psymon101/spinalhdlVDP/PROJECT_PLAN/sc17_hw_proof.png

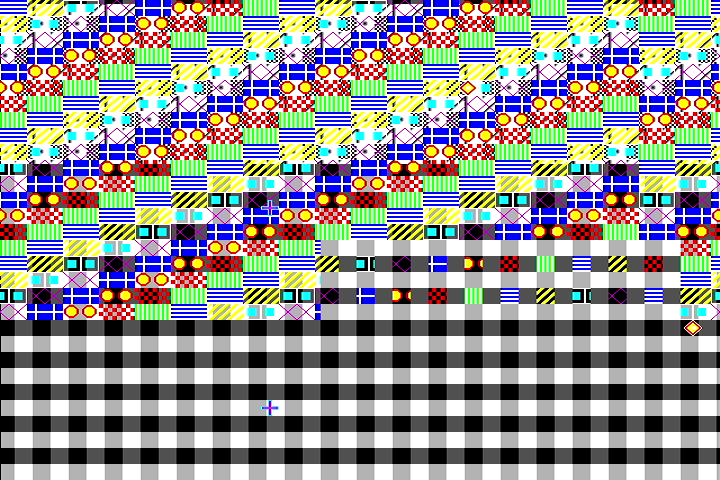
PROJECT_PLAN/sc17_hw_proof.png
