psymon101/spinalhdlVDP/PROJECT_PLAN/r53_hw_proof.png

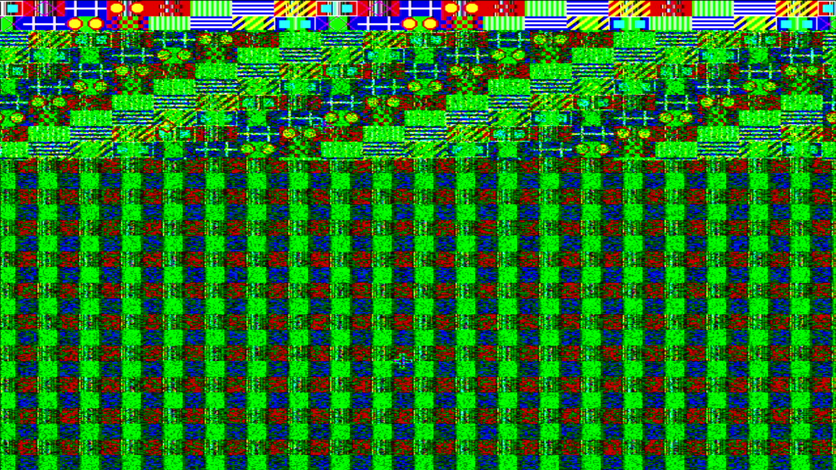
PROJECT_PLAN/r53_hw_proof.png
