psymon101/spinalhdlVDP/docs/external_documentation_system/docs/runbooks/08_RUN_HARDWARE_REGRESSION.md

# Run Hardware Regression

1. Verify source, bitstream, firmware, wiring, and asset hashes.
2. Program FPGA.
3. Flash host.
4. verify magic/ABI/capabilities;
5. run transport tests;
6. run Generic Mode0 tests;
7. run selected platform suite;
8. record status counters;
9. run reset/mode-switch tests;
10. run required soak;
11. capture direct-display and objective hash evidence;
12. complete proof packet.
