psymon101/spinalhdlVDP/docs/external_documentation_system/docs/testing/HARDWARE_PROOF_STANDARD.md

# Hardware Proof Standard

A proof identifies:

- source commit;
- generated RTL hash;
- bitstream hash;
- firmware hash;
- asset hashes;
- board and wiring revision;
- tool versions;
- exact commands;
- expected and actual results;
- status/error counters;
- test duration and reset count;
- reviewer.

A direct monitor is required for visual confirmation. Capture hardware is
secondary unless independently validated. Internal pixel hashes are preferred.
