psymon101/spinalhdlVDP/PROJECT_PLAN/BAD_APPLE_MODE0_DEMO.md

# BAD_APPLE_MODE0_DEMO.md

**Updated:** 2026-04-25  
**Purpose:** Define a bounded, explicitly non-roadmap demo experiment for playing a monochrome Bad Apple-style video directly on `Mode0` using the existing host-upload and bitmap-fetch infrastructure.

---

## Status

**Classification:** Fun / experimental demo  
**Roadmap status:** Not part of the formal adapter or substrate backlog  
**Intent:** Stress-test and showcase the existing host-upload + bitmap-fetch path without redefining core project scope

---

## Why This Exists

This demo asks a simple question:

> Can we preload a monochrome preprocessed video into SDRAM and display it on-screen using the current host + SDRAM + bitmap infrastructure?

This is **not** a C64 adapter goal and **not** a formal new `Mode0` primitive. It is a bounded experiment that may still teach useful lessons about:

- host preload throughput
- SDRAM write/update cadence
- bitmap fetch practicality
- what kinds of lightweight effects are possible on top of streamed content

---

## Scope

### In Scope

- monochrome video playback
- direct `Mode0` bitmap presentation
- preprocessed packed-monochrome frame playback from SDRAM
- one-shot preload or chunked rolling-buffer preload
- low-fps proof first
- optional visual effects layered on top later

### Explicitly Out of Scope

- audio playback
- C64-faithful presentation
- formal adapter work
- proving sustained high-bandwidth full-motion video as a guaranteed board capability
- changing project roadmap priority because the demo exists

---

## Recommended First-Cut Format

### Video Format

- resolution: `320x200`
- bit depth: `1bpp`
- packing: **packed monochrome**, `8 pixels per byte`, row-major
- palette: black / white
- source: offline-converted Bad Apple video frames

### Frame Size

`320 * 200 / 8 = 8000 bytes` per frame

### Initial Playback Goal

- first target: **10 fps**
- stretch target: **15 fps**
- do **not** assume `30 fps` as the first success criterion

---

## Playback Architecture

### High-Level Flow

```text
Bad Apple source video
  -> offline frame extraction + monochrome conversion
  -> packed 1bpp frame generation
  -> Pico 2 preload upload over QSPI
  -> SDRAM frame/chunk region
  -> Mode0 bitmap fetch
  -> fixed HDMI output
```

### Recommended First Strategy

Start with the simplest viable path:

1. preprocess source video into `320x200 1bpp` frames
2. preload full frames into SDRAM before playback begins
3. play locally from SDRAM at low fps
4. once proven, move to chunked rolling-buffer playback if the whole clip does not fit

### Better Practical Strategy

If the whole clip does not fit, switch to **chunked rolling-buffer preload**:

- preload several chunks before playback starts
- while chunk `N` is playing, upload future chunks
- reclaim already-consumed chunks and keep rotating through SDRAM

This keeps playback local to the Tang while only requiring the host link to stay ahead on average.

---

## Why `Mode0` Directly

This demo should target `Mode0` directly, not the C64 adapter, because:

- the goal is generic bitmap playback, not platform emulation
- `Mode0` already has bitmap-oriented substrate paths
- effects can be layered generically without pretending they are C64 semantics

This makes it a much cleaner stress/demo case.

---

## SDRAM / Fetch Model

### First-Cut Memory Model

- one or more SDRAM regions for packed-monochrome frames
- `Mode0` bitmap fetch reads from the active frame region
- playback logic advances frame/chunk pointers locally

### Optional Future Improvement

- dual frame regions with explicit swap control
- chunk ring-buffer with descriptor table for longer clips

This is not required for the first proof.

---

## Bandwidth Sanity Check

### Raw Full-Frame Cost

- frame size: `8000 bytes`
- `10 fps` -> `~80 KB/s`
- `15 fps` -> `~120 KB/s`
- `30 fps` -> `~240 KB/s`

These numbers exclude protocol overhead and control traffic.

### Interpretation

- low-fps monochrome playback is plausibly within reach
- raw full-frame `30 fps` should **not** be assumed without measurement
- preload-first playback is the preferred real path after initial proof
- chunked rolling-buffer preload is preferred over naive live streaming for larger clips

---

## Visual Presentation

### First Proof

- black / white monochrome
- no attempt to mimic C64, ZX, or any historical machine
- centered or letterboxed inside the fixed output raster

### Later Fun Additions

Once the basic stream works, allowed demo-only effects include:

- palette tinting
- raster splits
- overlay text/HUD
- sprite overlays
- window reveals / masks
- simple affine or distortion-style presentation if it can be layered cheaply

These remain demo effects, not new scope commitments.

---

## Implementation Phases

### Phase A — Static Bitmap Proof

Goal:

- host uploads one `320x200 1bpp` frame to SDRAM
- `Mode0` displays it correctly

Exit:

- clear visible static image on the HDMI output

### Phase B — Low-FPS Local Playback

Goal:

- host preloads successive packed-monochrome frames
- Tang plays locally from SDRAM
- playback is visibly recognizable as motion

Exit:

- a short recognizable monochrome animation at low fps

### Phase C — Chunked Rolling-Buffer Playback

Goal:

- host preloads several chunks ahead
- Tang consumes them locally while the host refills freed chunks
- full clip length exceeds one-shot SDRAM capacity

Exit:

- stable longer-form playback beyond one-shot SDRAM fit

### Phase D — Fun Effects

Goal:

- layer one or more generic `Mode0` effects over the streamed video

Exit:

- a visibly stylized demo without redefining mainline project scope

---

## Success Criteria

For the first success claim, the demo only needs to prove:

1. a preprocessed monochrome video frame can be uploaded by the host
2. `Mode0` can display the uploaded bitmap on screen
3. repeated updates produce recognizable motion

It does **not** need to prove:

- maximum fps
- zero tearing
- production-quality streaming protocol
- general-purpose video playback as a formal project feature

---

## Non-Goals / Guardrails

- Do not let this demo silently become a formal backlog commitment.
- Do not treat success here as proof that full-framebuffer video streaming is generally cheap on Tang Nano 20K.
- Do not widen `Mode0` for demo-only convenience without a separate architectural decision.
- Do not let the fun demo override `MODE0_PLANNING.md` §2 (Resource Stop-Lines).

---

## Recommended Next Concrete Step

If the team chooses to try this, the first implementation target should be:

- **Phase A — Static Bitmap Proof**

That will answer the first real question quickly:

- can the current host-upload + bitmap-fetch path display a streamed `320x200 1bpp` image cleanly enough to make the rest of the demo worth pursuing?
