psymon101/spinalhdlVDP/docs/firmware/HOST_TRANSPORT_ABI.md

> Live project state is maintained in repository-root `STATUS.md`. This document does not own active-lane status, blockers, or engineering history.

# Host Transport ABI

**Status:** draft  
**Owner:** `BronzeGate`  
**Reviewer:** `TopazCliff`, `BrightForge`

## Scope

Host-facing transport protocol for configuring the Tang Nano 20K VDP.

## Canonical host path

- **QSPI / ESP32-P4** is the canonical Tang Nano 20K host path.
- Components: `QspiSlave` / `QspiDecoder` / `QspiSdramBridge`.
- Historical i80/ESP32-S3 and legacy SPI paths are retired as primary targets.

## Transport rate

- **4 MHz** is the canonical bulk SDRAM upload clock for the current wiring.
- Legacy SPI contract: 2 MHz SCK, 10 µs CS hold, 20 µs OSR drain.

## Transport health

- Health selector: active word-drain `sel=0x0A`.
- `raw=0x00000000`, `overflow=0`, `malformed=0` expected in clean operation.
- Silent value corruption (no health flag) is a known SI-margin risk at higher
  rates; mitigated by 4 MHz canonical rate.

## Public API

Reusable host logic belongs in `firmware/libvdp/`. Applications remain thin
wrappers.

## Bitmap/indexed `SCALE_CTRL` semantics (P3b interface checkpoint)

BronzeGate concurs with BrightForge's **Option B — Compose**, pending PM and
CyanPeak review. The existing bitmap/indexed path's fixed 2× source-to-display
mapping remains part of the contract; `SCALE_CTRL` applies to the logical
coordinates before bitmap fetch. Therefore a bitmap's effective display scale
per axis is `2 × SCALE_CTRL` (subject to the active-display clamp), and the
default `scaleX=1`, `scaleY=1` remains byte-identical to the HW-proven
`a5a047a2` path.

Consequences for host code:

- A full 320×240 bitmap at `scaleX=scaleY=2` requests a 4× effective image and
  is larger than the 640×480 active area; use `LOGIC_WIDTH`/`LOGIC_HEIGHT` to
  crop the logical source before scaling when a zoomed image should fit.
- Write logical dimensions before `SCALE_CTRL`, using the existing
  `vdp_mode0_set_scale_mode()` helper or the equivalent two helpers.
- No new register, command, or libvdp helper is required. Existing scale
  fields retain their encoding; this section defines their bitmap/indexed
  fetch-side meaning for P3b.
- This semantic decision does not authorize RTL changes by itself. BrightForge
  must complete the checkpoint review, co-sim, and PnR gates before the fetch
  path changes.

## References

- `firmware/libvdp/`
- `firmware/GOTCHAS.md`
- `STATUS.md` lanes `QSPI-SI-CEILING-183`, `HAM6 removal + 2bpp indexed replacement`
