psymon101/spinalhdlVDP/docs/external_documentation_system/docs/platforms/amiga_ocs_ecs/README.md

# Amiga OCS/ECS

- **Current state:** BLOCKED — after Atari ST/STE
- **Dependencies:** independent 1–6 plane fetch, Copper, shared sprites, Blitter

## Documents

1. `SCOPE_AND_VIDEO_MODEL.md`
2. `FPGA_SPINALHDL_PLAN.md`
3. `FIRMWARE_LIBVDP_PLAN.md`
4. `TEST_AND_REVIEW_PLAN.md`
5. `LIMITATIONS_AND_DEFERRED.md`
6. `REFERENCES.md`

## Lane rule

No implementation starts before the research packet and design checkpoint are
approved. The adapter must reuse common engines unless an approved requirement
cannot be represented by them.
