psymon101/spinalhdlVDP/EDUCATION/05_FPGA_ARCHITECTURE.md

# FPGA Architecture and Resource Optimization

This document describes how the VDP SpinalHDL code is compiled, mapped to physical FPGA resources, and optimized to fit the constraints of the Gowin GW2AR-18 device.

---

## 1. Gowin GW2AR-18 Architecture Overview

The **Tang Nano 20K** board features a Gowin GW2AR-LV18QN88C8/I7 FPGA. This chip has the following logic capacity:

| Resource Type | Available Count | Description |
|---|---|---|
| **LUT4** (Look-Up Table) | 20,736 | 4-input logic function generators |
| **DFF** (Flip-Flops) | 15,552 | 1-bit memory elements (registers) |
| **BSRAM** (Block SRAM) | 46 blocks | On-chip memory blocks (18 Kbits each) |
| **DSP Blocks** | 40 blocks | Dedicated multiplier / ALU blocks |

---
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
