psymon101/spinalhdlVDP/firmware/zx_final_proof_v4.png

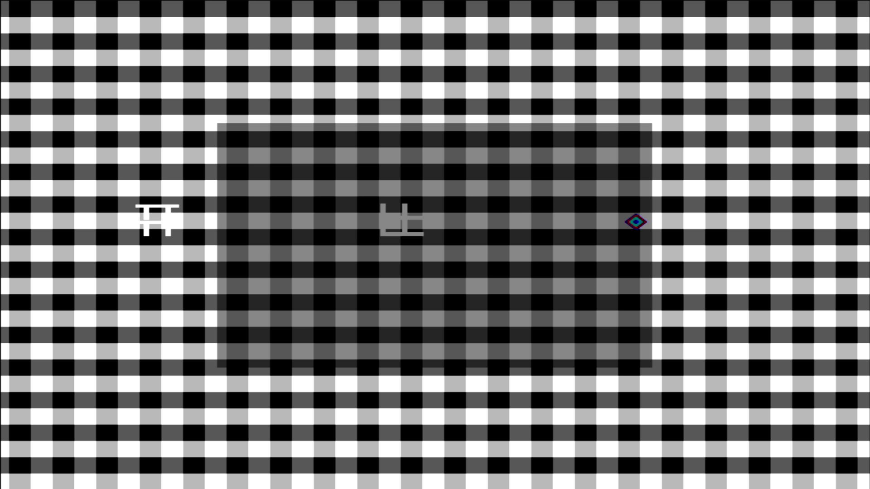
firmware/zx_final_proof_v4.png
