psymon101/spinalhdlVDP/PROJECT_PLAN/proof_packets/2bpp-hardware-reproof-4mhz/yuyv_exact_approved_frame_01.png

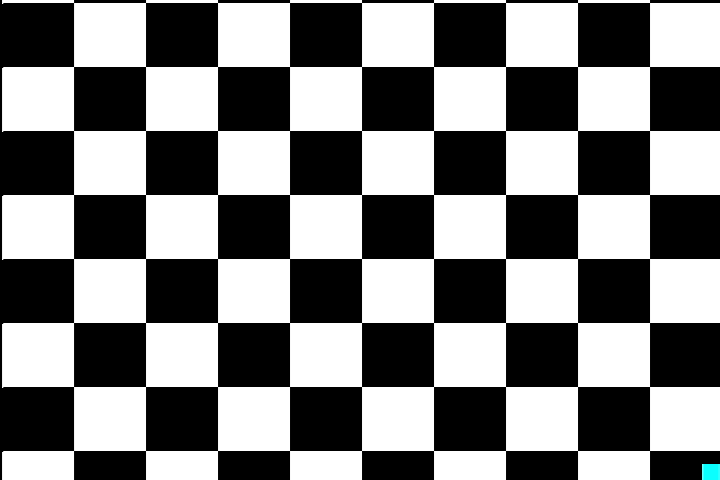
PROJECT_PLAN/proof_packets/2bpp-hardware-reproof-4mhz/yuyv_exact_approved_frame_01.png
