psymon101/spinalhdlVDP/PROJECT_PLAN/proof_packets/qspi-upload-si-hardening/captures/indirect_display_frame_01.png

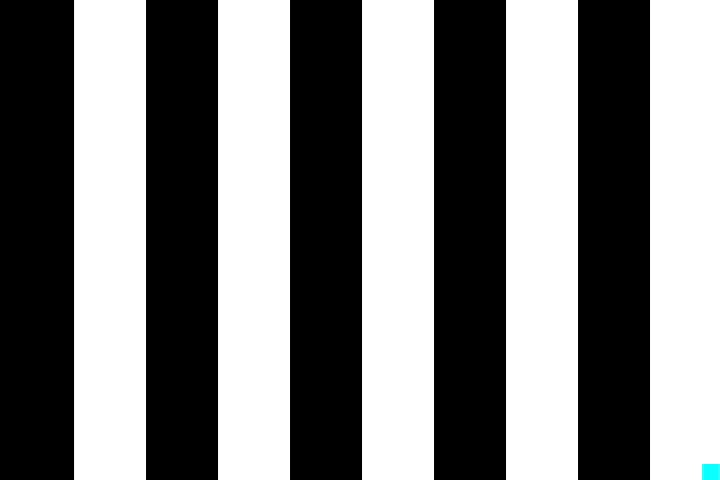
PROJECT_PLAN/proof_packets/qspi-upload-si-hardening/captures/indirect_display_frame_01.png
