psymon101/spinalhdlVDP/PROJECT_PLAN/proof_packets/scaler-rewrite-hw-proof/captures/phaseC_2x/mode2_2x_scaled.png

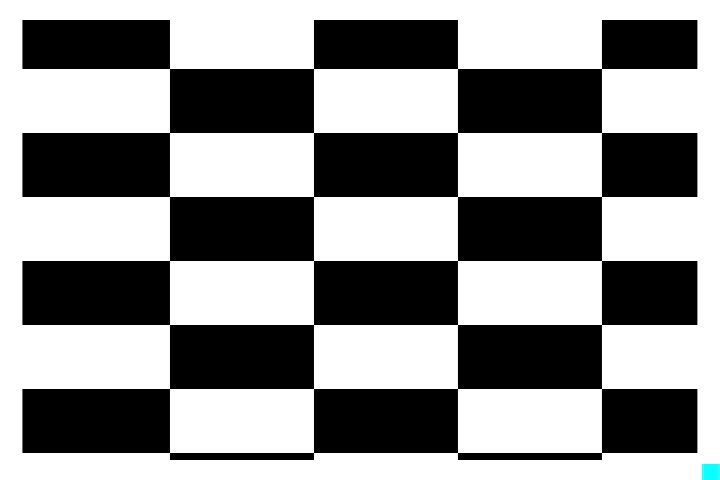
PROJECT_PLAN/proof_packets/scaler-rewrite-hw-proof/captures/phaseC_2x/mode2_2x_scaled.png
