psymon101/spinalhdlVDP/PROJECT_PLAN/proof_packets/scaler-rewrite-hw-proof/captures/phaseC_3x/mode3_3x_scaled.png

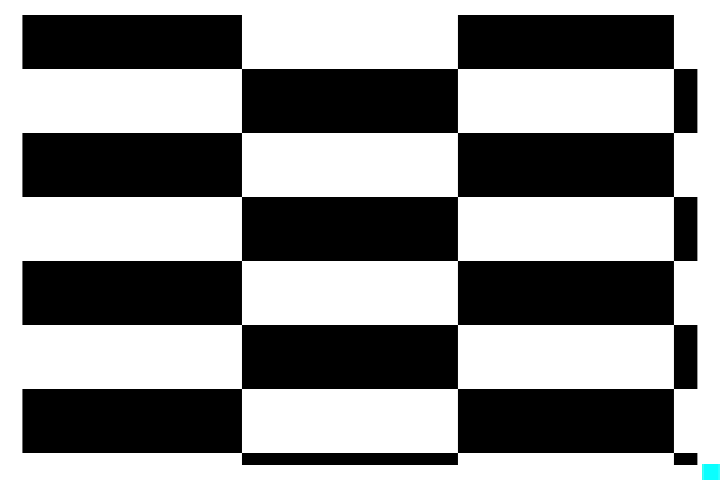
PROJECT_PLAN/proof_packets/scaler-rewrite-hw-proof/captures/phaseC_3x/mode3_3x_scaled.png
