psymon101/spinalhdlVDP/PROJECT_PLAN/r41c_hw_proof.png

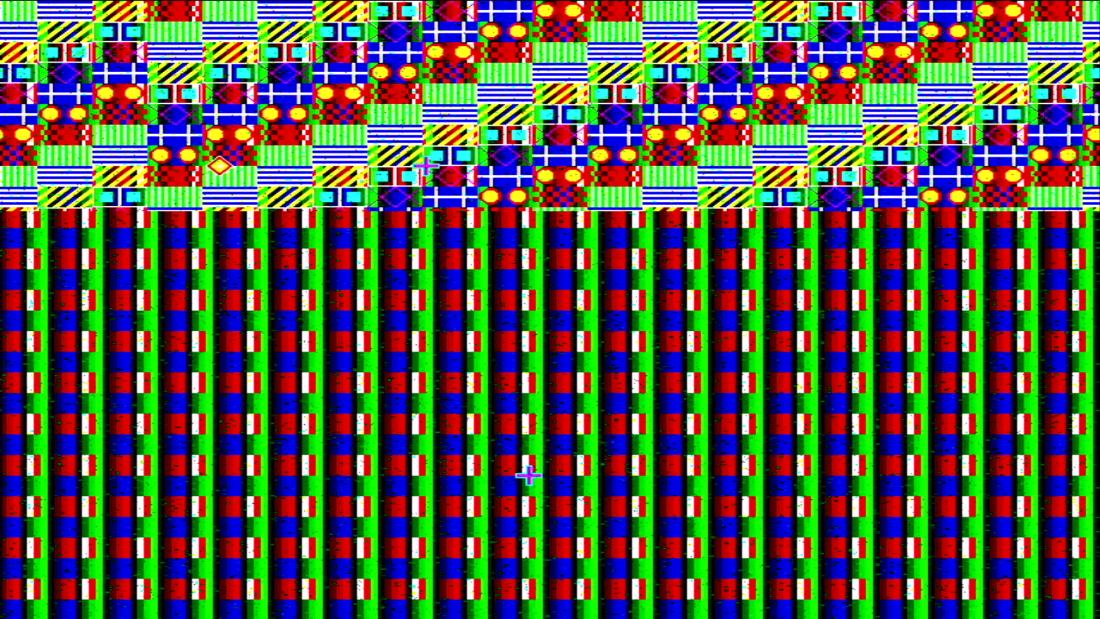
PROJECT_PLAN/r41c_hw_proof.png
