psymon101/spinalhdlVDP/PROJECT_PLAN/sc12_hw_proof.png

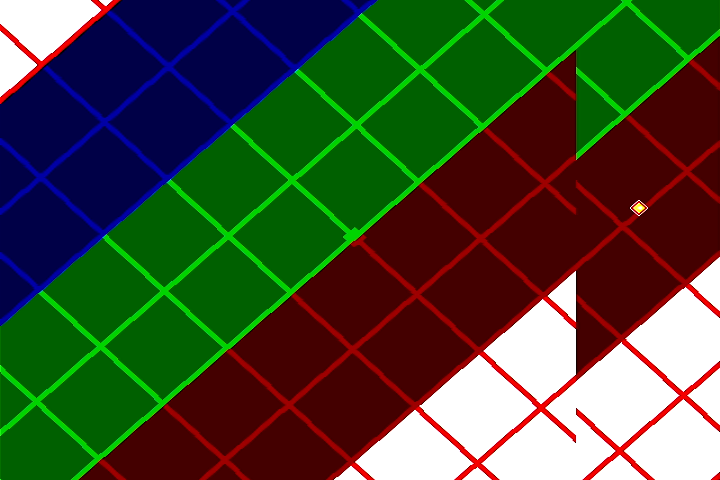
PROJECT_PLAN/sc12_hw_proof.png
