psymon101/spinalhdlVDP/PROJECT_PLAN/sc13_hw_proof.png

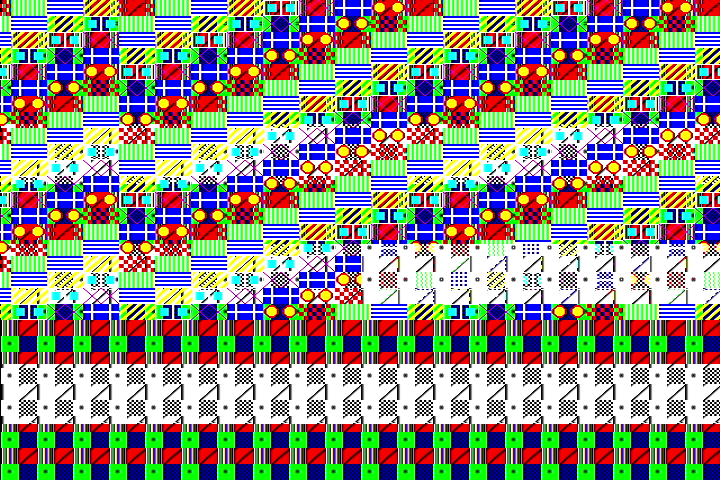
PROJECT_PLAN/sc13_hw_proof.png
