psymon101/spinalhdlVDP/docs/external_documentation_system/docs/runbooks/07_BUILD_ESP32_P4.md

# Build ESP32-P4 Backend

Status: blocked until the P4 backend is integrated into `libvdp`.

The final runbook must cover:

- exact ESP-IDF version;
- board/pin definition;
- required I/O power-domain setup;
- chosen i80/PARLIO or approved transport;
- write framing;
- manual or hardware readback;
- build, flash, and monitor commands;
- transport conformance and Generic Mode0 proof.
