psymon101/spinalhdlVDP/docs/runbooks/BUILD_LIBVDP.md

> Live project state is maintained in `PROJECT_PLAN/STATUS.md`. This document does not own active-lane status, blockers, or engineering history.

# Runbook: Build libvdp

**Owner:** `BronzeGate`  
**Status:** template — requires validation for CMake target

## Working directory

`/home/itadmin/github/spinalhdlVDP/firmware/libvdp`

## Prerequisites

- Platform toolchain installed (ESP-IDF v6.0.2 for ESP32-P4).

## Command

```bash
# TBD — validate with BronzeGate
```

## Expected outputs

- Compiled `libvdp` object files / static library.

## Pass/fail criteria

- Build exits 0 with no warnings treated as errors.

## Evidence to save

- Build log.
- Commit hash.
