psymon101/spinalhdlVDP/docs/external_documentation_system/docs/runbooks/01_SETUP_DEVELOPMENT_ENVIRONMENT.md

# Setup Development Environment

This runbook is not complete until Foundation 0 locks exact versions.

1. Acquire the supported OS/container.
2. Verify source archive hash.
3. Install the locked JDK, Scala, sbt, SpinalHDL, simulator, Gowin EDA,
   host SDK, compiler, Python, CMake, and flashing tools.
4. Run `tools/verify_toolchain` once implemented.
5. Clone/checkout the locked commit.
6. Confirm clean tree.
7. Run the smoke build.
8. Save `tool_versions.txt`.

All exact commands and expected versions remain `TBD-FOUNDATION-0`.
