psymon101/spinalhdlVDP/docs/external_documentation_system/docs/runbooks/06_BUILD_LIBVDP_AND_REFERENCE_FIRMWARE.md

# Build libvdp and Reference Firmware

1. Verify ABI/register generated headers.
2. Build the authoritative host target.
3. Build secondary supported targets.
4. Build Generic Mode0 example.
5. Build every closed platform example.
6. run software unit/mock tests;
7. record binary hashes and map/size reports.
