psymon101/spinalhdlVDP/docs/external_documentation_system/docs/runbooks/09_BUILD_RELEASE.md

# Build Release

1. require all milestone lanes closed;
2. run clean-room build;
3. generate and hash RTL;
4. synthesize and hash bitstream;
5. build and hash firmware;
6. package source, manifests, reports, tests, docs, and proofs;
7. verify archive from a new extraction;
8. collect all sign-offs.
