psymon101/spinalhdlVDP/PROJECT_PLAN/proof_packets/standalone-diagnostic-build/captures/coldpor_cycle01.png

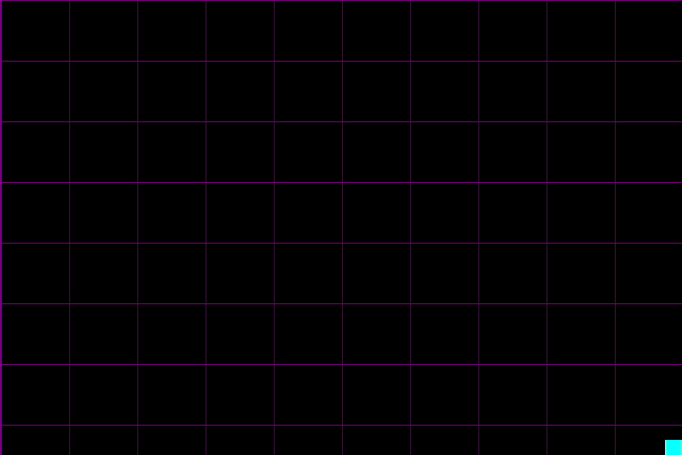
PROJECT_PLAN/proof_packets/standalone-diagnostic-build/captures/coldpor_cycle01.png
