psymon101/spinalhdlVDP/docs/external_documentation_system/docs/testing/GOLDEN_VECTORS.md

# Golden Vectors

Every closed engine/platform publishes:

- smallest legal vector;
- representative vector;
- boundary/stress vector;
- invalid vector;
- raster vector where applicable;
- input hashes;
- expected pixel/line/frame hashes;
- expected status bits;
- expected transaction trace.

Random failures become permanent seeded regressions.
