psymon101/spinalhdlVDP/docs/external_documentation_system/docs/platforms/amiga_ocs_ecs/TEST_AND_REVIEW_PLAN.md

# Amiga OCS/ECS — Test and Review Plan

## Required tests

- AMIGA-SIM-001..006 plane counts
- AMIGA-SIM-010 independent bases
- AMIGA-SIM-011 odd/even modulo
- AMIGA-SIM-020 dual playfield
- AMIGA-SIM-030 sprites/attached
- AMIGA-SIM-040 Copper mid-line
- AMIGA-SIM-050 EHB
- AMIGA-SIM-060 HAM6 and line reset
- AMIGA-HW-001 Blitter-generated proof

## Test case template

Every test states:

- requirement IDs;
- exact input vector and hash;
- initial register/memory state;
- simulation or hardware command;
- expected pixel/line/frame hash;
- expected status flags;
- maximum latency/time;
- pass/fail condition;
- evidence path.

## Review sequence

1. platform research review;
2. design/Mode0 mapping review;
3. SpinalHDL unit review;
4. SpinalSim review;
5. `VdpTop`/SDRAM integration review;
6. `libvdp` API review;
7. schema/document synchronization;
8. synthesis/timing/resource review;
9. hardware proof review;
10. independent clean-room/doc audit.

## Closure

All supported claims must map to passing tests. Visual inspection alone cannot
close the lane.
