psymon101/spinalhdlVDP/PROJECT_PLAN/external_review/full_codebase_audit_2026-07-27/final_verification_2026-08-03/README.md

# Final Verification Package — `codebase-cleanup-status-contract`

**Date:** 2026-08-03  
**Lane:** `codebase-cleanup-status-contract`  
**Branch:** `brightforge/status-contract-cleanup` (base `main` `fd39d2b0`)  
**PM:** TopazCliff  

This package contains everything the external AI reviewer needs for the **final verification gate** before the Project Lead authorizes merging the cleanup lane into `main`.

## Files

| File | Purpose |
|---|---|
| `final_verification_request_for_external_ai.md` | The verification request with context, questions, and verdict format. |
| `rtl_implementation_bundle.md` | High-level contract map, source-diff summary, simulation results, PnR summary, and artifact hashes. |
| `rtl_source.diff` | 261-line full diff of `main..brightforge/status-contract-cleanup`. |
| `review.md` | CyanPeak's Step C firmware contract-sync verdict (PASS). |
| `hashes.sha256` | SHA-256 hashes of firmware build artifacts. |
| `manifest.yaml` | Proof-packet manifest with commit references and mail threads. |

## Reference contract

The approved host-visible contract is in:

`PROJECT_PLAN/external_review/full_codebase_audit_2026-07-27/rule19_signoff_request.md`

## Gate status

- Rule 19 sign-off: BrightForge #14629, BronzeGate #14631, External AI approval ✅
- CyanPeak code-to-spec review: PASS (#14647) ✅
- BronzeGate Step C firmware/header sync + builds: PASS (#14650) ✅
- BrightForge Step B RTL + sim + PnR: PASS (#14643) ✅
- **Remaining gate:** External AI final verification → PM merge authorization.
