psymon101/spinalhdlVDP/kb/TEMPLATE_ADAPTER/TEST_AND_PROOF_PLAN.md

> Live project state is maintained in repository-root `STATUS.md`. This document does not own active-lane status, blockers, or engineering history.

# `<Adapter>` Test and Proof Plan

**Owner:** BrightForge + BronzeGate  
**Reviewers:** advisory reviewers as activated

## Simulation tests

| Test ID | Requirement | Owner | Command | Pass criteria |
|---|---|---|---|---|

## Hardware proof

| Test ID | Procedure | Owner | Pass criteria | Evidence |
|---|---|---|---|---|

## Golden vectors

## Proof packet location

`PROJECT_PLAN/proof_packets/<LANE>/`
