psymon101/spinalhdlVDP/PROJECT_PLAN/external_review/full_codebase_audit_2026-07-27/final_verification_2026-08-03/review.md

# Step C review

Verdict: PASS for the BronzeGate firmware scope.

Evidence:

- Source commit `a5f2aaa93e89d3afbb4b0adf041eb19582508251` contains only the
  five assigned firmware contract/schema files.
- ESP32-P4 proof builds for modes 0, 2, and 3 passed with ESP-IDF v6.0.2.
- Artifact hashes are recorded in `hashes.sha256`.
- `git diff --check` passed before the source commit.
- JSON validation passed with `python3 -m json.tool firmware/libvdp/mode0_regs.json`.
- No merge was attempted. External-AI final verification and explicit PM merge
  authorization remain open gates.
