psymon101/spinalhdlVDP/PROJECT_PLAN/proof_packets/scaler-rewrite-merge-prep/simulation/results.txt

Indexed2bppFineCoSim=0
Indexed2bppCheckerCoSim=0
Indexed2bppFrameCoSim=0
DirectColorFrameCoSim=0
pnr=0
