psymon101/spinalhdlVDP/docs/external_documentation_system/docs/platforms/atari_2600_tia/TEST_AND_REVIEW_PLAN.md

# Atari 2600 TIA — Test and Review Plan

## Required tests

- TIA-SIM-001 playfield reflection
- TIA-SIM-010 player copy/size
- TIA-SIM-020 missile/ball
- TIA-SIM-030 motion
- TIA-SIM-040 priority
- TIA-SIM-050 collision matrix
- TIA-HW-001 timed mid-line proof

## Test case template

Every test states:

- requirement IDs;
- exact input vector and hash;
- initial register/memory state;
- simulation or hardware command;
- expected pixel/line/frame hash;
- expected status flags;
- maximum latency/time;
- pass/fail condition;
- evidence path.

## Review sequence

1. platform research review;
2. design/Mode0 mapping review;
3. SpinalHDL unit review;
4. SpinalSim review;
5. `VdpTop`/SDRAM integration review;
6. `libvdp` API review;
7. schema/document synchronization;
8. synthesis/timing/resource review;
9. hardware proof review;
10. independent clean-room/doc audit.

## Closure

All supported claims must map to passing tests. Visual inspection alone cannot
close the lane.
