psymon101/spinalhdlVDP/docs/external_documentation_system/docs/platforms/genesis/TEST_AND_REVIEW_PLAN.md

# Sega Mega Drive/Genesis — Test and Review Plan

## Required tests

- GEN-SIM-001 A/B/window priority
- GEN-SIM-010 tile priority/flips
- GEN-SIM-020 scroll modes
- GEN-SIM-030 sprite boundary
- GEN-SIM-040 shadow/highlight
- GEN-HW-001 width/mode proof

## Test case template

Every test states:

- requirement IDs;
- exact input vector and hash;
- initial register/memory state;
- simulation or hardware command;
- expected pixel/line/frame hash;
- expected status flags;
- maximum latency/time;
- pass/fail condition;
- evidence path.

## Review sequence

1. platform research review;
2. design/Mode0 mapping review;
3. SpinalHDL unit review;
4. SpinalSim review;
5. `VdpTop`/SDRAM integration review;
6. `libvdp` API review;
7. schema/document synchronization;
8. synthesis/timing/resource review;
9. hardware proof review;
10. independent clean-room/doc audit.

## Closure

All supported claims must map to passing tests. Visual inspection alone cannot
close the lane.
