psymon101/spinalhdlVDP/docs/external_documentation_system/docs/platforms/zx_spectrum/TEST_AND_REVIEW_PLAN.md

# ZX Spectrum — Test and Review Plan

## Required tests

- ZX-SIM-001 shuffled address vectors
- ZX-SIM-002 attribute truth table
- ZX-SIM-003 flash cadence/reset
- ZX-SIM-004 border boundary
- ZX-HW-001 attribute-clash scene
- ZX-HW-002 cold/reset/mode soak

## Test case template

Every test states:

- requirement IDs;
- exact input vector and hash;
- initial register/memory state;
- simulation or hardware command;
- expected pixel/line/frame hash;
- expected status flags;
- maximum latency/time;
- pass/fail condition;
- evidence path.

## Review sequence

1. platform research review;
2. design/Mode0 mapping review;
3. SpinalHDL unit review;
4. SpinalSim review;
5. `VdpTop`/SDRAM integration review;
6. `libvdp` API review;
7. schema/document synchronization;
8. synthesis/timing/resource review;
9. hardware proof review;
10. independent clean-room/doc audit.

## Closure

All supported claims must map to passing tests. Visual inspection alone cannot
close the lane.
