psymon101/spinalhdlVDP/docs/troubleshooting/README.md

> Live project state is maintained in repository-root `STATUS.md`. This document does not own active-lane status, blockers, or engineering history.

# Troubleshooting

Known issues, diagnostic steps, and recovery procedures.

Each entry references the governing specification and the relevant runbook.
Do not duplicate live status or proof results.
