psymon101/spinalhdlVDP/PROJECT_PLAN/TASKS_HISTORY.md

# TASKS_HISTORY.md

**Version:** 1.1-draft  
**Author:** CyanPeak (audit update)  
**Date:** 2026-05-24 (Lane #10567 closure added)  
**Purpose:** Deep historical record for closed lanes, extended task writeups, and archived execution detail. `TASKS.md` remains the sole active task authority; this file is reference only.

---

### RTL Platform-Agnosticism Purge (CLOSED)

| Field | Value |
|---|---|
| **Task** | RTL Platform-Agnosticism Purge (#10567) |
| **Status** | **DONE** — CyanPeak audit PASS #10587 |
| **Phase** | closed |
| **Owner** | BrightForge (deletion), CyanPeak (audit), TopazCliff (coordination) |
| **Baseline Commit** | `8b61a2e` (RTL Cleanup) |
| **Commits in lane** | `66dc25f` (RTL purge) |
| **Latest Auth Mail** | #10567 (Lane Open), #10576 (Scope Change), #10581 (Audit GO), #10587 (Audit PASS) |
| **Proof** | Generic sims PASS: \`TileAttributeFetchSim\`, \`SdramTileFetchSim\`, \`SpriteSpriteCollisionSim\`. Recursive grep returns zero behavioral matches in \`hw/spinal/\`. |
| **Next Deliverable** | N/A — Lane #10567 closed |

**Scope:** Strip all platform-specific RTL (adapters, shims, hardcoded assets, and scenarioId parameterization) to enforce the **RTL Agnosticism** principle. Personality moves to \`libvdp\`.

**Implementation:**
- Deleted 10 files covering Tier 1/2 platform IP (C64, ZX, Mode-Select).
- Scrubbed \`TopTang20kHdmi.scala\`: dropped \`scenarioId\` and \`useHostInit\` parameters. Folded all per-scenario logic into a single generic 'Pure Host' path.
- Removed hardcoded palettes from \`TileAttributeAssets.scala\`.
- Cleaned up stale platform-specific comments in core VDP logic.

**Orphan Retentions:** \`C64CharRom.scala\` and \`peptoPalette\` retained for future firmware-side backfill.

---

### Task 54 — Sprite-Sprite Collision Detector (CLOSED)

| Field | Value |
|---|---|
| **Task** | Task 54 — Sprite-Sprite Collision Detector |
| **Status** | **DONE** — CyanPeak audit PASS #9672; sim-only proof |
| **Phase** | closed |
| **Owner** | BrightForge (implementation + proof), CyanPeak (audit PASS), CoralReef (ledger sync) |
| **Baseline Commit** | `fae0585` (Task 57 closure, descCount=8 substrate) |
| **Commits in lane** | `e556ff5` (Implementation + SpriteSpriteCollisionSim) |
| **Latest Auth Mail** | #9616 (Lane Open), #9620 (CP Checkpoint A PASS), #9625 (BF proof), #9672 (CP audit PASS) |
| **Proof** | `SpriteSpriteCollisionSim` 5/5 cases PASS (non-overlap, two-overlap, three-overlap, W1C, lone-sprite). Regression 9/9 PASS bit-identical. |
| **Next Deliverable** | N/A — Task 54 closed |

**Scope:** Pairwise sprite-sprite overlap detection for active/visible sprites. Host-visible sticky mask at `0x0322` (`SPRITE_COLL_MASK`, 8-bit per-descriptor, W1C) and rollup bit in `STATUS_STICKY` @ `0x0320[6]` (`SPRITE_SPRITE_HIT`).

**Implementation:** The `SpriteRasterizer` line-buffer was widened from 10 → 16 bits to store the `descriptorIndex` of the writing sprite. Write-time collision is detected by asynchronously reading the buffer's existing entry before overwriting; if both current and existing pixels are non-transparent, a collision event for both descriptor IDs is emitted. This architecture correctly accumulates all participating sprites in a multi-way overlap due to the reverse-iteration draw order.

**Resource Impact:** Widening the line buffer (640 × 16 bits × 2 banks) added ~7,680 bits (~1.14 BSRAMs). DFF impact was negligible. Headroom remains >50% (BSRAM: 23/46 at descCount=8).

**Out of scope held:** No widening of the C64 adapter `$D01E` shadow plumbing in this lane. The underlying mask register is host-readable via `io.spriteCollMask`; full adapter-side wiring is deferred to a follow-on if needed.

---

### Task 55 — Sprite Masking + Tile-Fetch Budget Counter (CLOSED)

| Field | Value |
|---|---|
| **Task** | Task 55 — Sprite Masking + Tile-Fetch Budget Counter |
| **Status** | **DONE** — CyanPeak audit PASS #9479; sim-only closure approved |
| **Phase** | closed |
| **Owner** | BrightForge (coding + proof), CyanPeak (audit PASS), CoralReef (ledger sync) |
| **Baseline Commit** | `90b2dd8` (Task 53 closure) |
| **Commits** | `0f96777` (CP-B base); `26174a7` (CP-B+ fix); `9e888bd` (Sc55 gen) |
| **Latest Auth Mail** | #9460 (BrightForge corrected proof); #9461 (CyanPeak B-PASS); #9474 (HW blocker); #9479 (CyanPeak final PASS) |
| **Proof** | Behavioral sim Cases 4 & 5 prove pixel suppression; `Task55SpriteMaskingSim` Cases D/E prove 34/35 tile budget boundary; fixed `slotIdx` misalignment bug. |
| **Next Deliverable** | N/A — Task 55 closed |

**Scope:** Genesis-style sprite masking (word 8 bit [4] + suppression gate) and SNES-style 34-tiles/line fetch budget (counter + status flag).

**Hardware Blocker:** Checkpoint C (hardware proof) was blocked by an authoritative DFF overrun on the Tang Nano 20K (17750 / 15915, 111%). Blocker is pre-existing substrate-wide (Task 2b). CyanPeak #9479 approved sim-only closure given the exceptionally strong behavioral proof and the risk of bundling a structural refactor into Task 55. Task 57 (Optimization) opened in backlog to recover headroom.

---

### Task 2a Checkpoint 1 Milestone — Tree-Pipelined Sprite Priority Merge
**Context:** Task 2 direct 64/32 bump blocked by #9210. BronzeGate #9212 → 2a/2b split. Checkpoint 1 PASS #9222. Checkpoint 2 WIP retired after V=16 P&R failed (#9231). Convergent diagnosis #9233/#9234 → Sequential Scanline Rasterizer. BronzeGate #9235 authorized reshape. BrightForge #9236 design packet. CyanPeak #9237 audit PASS. Coding active.
| Field | Value |
|---|---|
| **Task** | Task 2a Checkpoint 1 — Tree-pipelined sprite priority merge |
| **Status** | **DONE** — CyanPeak audit PASS #9222 |
| **Phase** | closed (sub-milestone) |
| **Owner** | BrightForge (coding + proof), CyanPeak (audit PASS) |
| **Commit** | `994633a` (+130/−55, `VdpTop.scala` only) |
| **Latest Auth Mail** | #9221 (BrightForge proof packet), #9222 (CyanPeak audit PASS) |
| **Proof** | 2-stage tree priority encoder (2×4 groups) with `RegNext×2` delay compensation; all 8 regression sims PASS bit-identical; Gowin timing 0 violations; −104 LUT vs baseline |

### Task 2a Closure Milestone — Sequential Scanline Rasterizer Substrate

| Field | Value |
|---|---|
| **Task** | Task 2a — Sprite Capacity Substrate Pre-Hardening (FULL CLOSURE) |
| **Status** | **DONE** — BronzeGate #9252 accepted CLOSED; CyanPeak #9250 audit PASS |
| **Phase** | closed |
| **Owner** | BrightForge (coding + proof), CyanPeak (audit PASS), BronzeGate (PM closeout) |
| **Commits** | `45369b0` (SpriteRasterizer module); `12df99d` (Step 1 parallel wiring); `983d1db` (Step 2 cutover); `c68d557` (SpriteSubstrateSim Cases A–D) |
| **Latest Auth Mail** | #9250 (CyanPeak audit PASS), #9252 (BronzeGate PM closeout) |
| **Proof** | V=8 bit-identical regression 8/8 PASS; +83 logic vs Checkpoint 1; 0 timing violations; V=32 projection 15,930 logic (77%), 11,729 LUT — renderer substrate scales flatly |

### Task 2c — Sprite Evaluator Hardening (CLOSED)

| Field | Value |
|---|---|
| **Task** | Task 2c — Sprite Evaluator Hardening |
| **Status** | **DONE** — CyanPeak audit PASS #9278; BronzeGate PM closeout #9279 |
| **Phase** | closed |
| **Owner** | BrightForge (coding + proof), CyanPeak (audit PASS), CoralReef (ledger), BronzeGate (PM closeout) |
| **Baseline Commit** | `ab687d1` (Task 2a closeout) |
| **Commits** | `b2f4a5d` (CP-C evaluator RAM); `7b42b6a` (CP-D+E rasterizer narrow + VdpTop wiring); `b558cee` (CP-F final cleanup) |
| **Latest Auth Mail** | #9265–#9268 (BrightForge proof packet); #9276 (CoralReef ledger sync); #9278 (CyanPeak audit PASS); #9279 (BronzeGate closeout + Task 2b activation) |
| **Proof** | V=32: 13,940 logic (68%), 9,611 LUT, 7,726 FF, 0 unplaced REGs, 0 timing violations; V=8: 13,625 logic (66%), 9,103 LUT, 6,982 FF; regression 10/10 PASS |
| **Next Deliverable** | N/A — Task 2c closed |

**Scope:** Replace SpriteEvaluator `active*` Vec FF duplication with RAM-based active-list storage; narrow SpriteRasterizer interface to RAM read port; remove dead `activeY`. Target: V=32 places with zero unplaced REGs.

### Task 2b — Sprite Capacity Bump (CLOSED)

| Field | Value |
|---|---|
| **Task** | Task 2b — Sprite Capacity Bump |
| **Status** | **DONE** — CyanPeak audit PASS #9286/#9298; BronzeGate closeout #9287/#9293/#9294 |
| **Phase** | closed |
| **Owner** | BrightForge (coding + proof), CyanPeak (audit PASS), BronzeGate (PM closeout) |
| **Baseline Commit** | `b558cee` (Task 2c closure) |
| **Commits in lane** | `2281482` (parameter bump V=8→32/D=32→64); `a268e1e` (SpriteSubstrateSim Cases E+F) |
| **Artifact** | `PROJECT_PLAN/archive/tasks/TASK_2B_SPRITE_CAPACITY_BUMP.md` |
| **Latest Auth Mail** | #9295 (BrightForge HW proof v2); #9298 (CyanPeak re-audit PASS) |
| **Next Deliverable** | N/A — fully closed |

| **Proof** | V=32: 13,924 logic (68%), 9,595 LUT, 7,726 FF, 0 unplaced REGs, 0 timing violations. HW proof v2: 30s capture, 868 frames, 28 visible sprites, freeze=0.0000, glitch=0.0000. Regression 10/10 PASS. Total trajectory: 51,191 → 13,924 = 3.7× reduction.

---

### Task 52 — Per-Sprite X/Y Flip Primitive (CLOSED)

| Field | Value |
|---|---|
| **Task** | Task 52 — Per-Sprite X/Y Flip Primitive |
| **Status** | **DONE** — CyanPeak audit PASS #9127; hardware verified |
| **Owner** | BrightForge (implementation + proof), CyanPeak (audit), BronzeGate (firmware) |
| **Baseline Commit** | `39a7242` (Sprite Phase 2) |
| **Latest Auth Mail** | #9127 (CyanPeak audit PASS) |
| **Proof** | \`SpriteFlipSim\` 12/12 cases PASS; hardware proof Scenario 62 shows pixel-perfect mirror grid on Tang Nano 20K. |

---

### ESP32-S3 Host Bring-up (CLOSED)

| Field | Value |
|---|---|
| **Task** | ESP32-S3 Host Bring-up — Hardware SPI2 + DMA |
| **Status** | **DONE** — Finalized #10541; bitstream `8b61a2e` |
| **Owner** | BronzeGate (firmware), BrightForge (RTL support) |
| **Latest Auth Mail** | #10539 (Root cause SOLVED), #10541 (Closeout) |
| **Proof** | Hardware SPI2 at 60 MHz (write) / 3 MHz (read). Bit-perfect palette writes proven via \`esp32s3_red_screen\`. |

---

### Scanline-start 1-pixel Transient Fix (CLOSED)

| Field | Value |
|---|---|
| **Task** | Scanline-start 1-pixel Transient Fix |
| **Status** | **DONE** — CyanPeak audit PASS #10546; hardware fixed |
| **Owner** | BrightForge (implementation), CyanPeak (audit PASS), BronzeGate (verification) |
| **Commit** | \`a98ad0a\` (local only) |
| **Latest Auth Mail** | #10550 (FIXED on bench), #10552 (Ready to commit) |
| **Proof** | RTL pre-advance \`(hCounter + 1)\` aligned fetch latency with compositor. Left-edge green strip eliminated on HW bench. |

---

### Task 3 — Planar Fetch Hardening (DONE)

| Field | Value |
|---|---|
| **Task** | Task 3 — Planar Fetch Hardening (2→5+ planes) |
| **Status** | **DONE** — M3 audit PASS #9406. Fix `452c3db`: one-line modulo wrap `VdpTop.scala:888` + `PlanarPixelIdxBoundsSim` discriminator. Canonical SMPTE bars, gray block cleared, 0 timing violations. |
| **Phase** | implement (domain migration) |
| **Owner** | BrightForge (coding + proof), CyanPeak (audit), BronzeGate (PM), CoralReef (ledger/sync) |
| **Baseline Commit** | `ef49c5f` (gap task list updated post-Task-2b; now archived in `PROJECT_PLAN/archive/tasks/`) |
| **Commits in lane** | `ee829e5` (CP-C); `8cf0621` (CP-D); `363e3e4` (CP-E); `44efa3f` (Mem refactor); `527c026` (narrow fix attempt); `df57d61` (bypass discriminator); `f4b04a9` (unified unblock attempt); `cf5722e` (Path A M1 sim-PASS); `452c3db` (Path A M3 fix — modulo wrap + discriminator sim) |
| **Artifact** | `PROJECT_PLAN/archive/tasks/TASK_3_PLANAR_FETCH_HARDENING.md` |
| **Latest Auth Mail** | #9406 (CyanPeak M3 audit PASS — Task 3 Path A CLOSED) |
| **Next Deliverable** | N/A — Task 3 Path A closed. Follow-on: 320-pixel clipping mask per CyanPeak #9406 recommendation if planar window confinement is required. |

**Scope:** Integrate `PlanarLineFetch` into main `VdpTop` pipeline as selectable L0 source. Raise planar plane count from 2 → 5+ (target 5 for Amiga OCS, 6 for EHB). Add scheduler slot(s) for planar row fetch. Wire SDRAM `dout32` aperture to planar fetch client. Add `planeBaseAddr[0..4]` register-bus addresses. Bit-identical regression (Scenarios 9/10). Sim proof: `PlanarIntegrationSim` + `PlanarBandwidthSim`. Synthesis delta +400–600 LUT. HW proof: 5-plane diagnostic scene, 30s capture, freeze=0.

**Key context:** This is an **integration lane**, not a rewrite. Standalone primitives `BitplaneReconstruct`, `BitplaneRowFetch`, `PlanarLineFetch`, and `Hdmi720pPlanarProofTop` already exist and are proven. Gap = production integration into scheduler + SDRAM arbiter + L0 source mux.

**Current pivot:** The pixel-domain fetch path (narrow fix `527c026`, unified unblock `f4b04a9`) proved insufficient on hardware — uniform gray persisted despite sim PASS and synth clean. BronzeGate #9364 ruled Path A domain migration as the active unblock lane: move `PlanarLineFetch` / `BitplaneRowFetch` SDRAM consumption into `sdramClockDomain`, following the established `BitmapRowFetch` / `SdramTileAttributeFetch` pattern. BrightForge landed M1 sim-PASS at `cf5722e` (#9377) and M2 synth PASS #9386 (0 violations, 0 unplaced REGs). M3 hardware proof #9392 revealed planar bars ARE present end-to-end but layout is corrupted: hard boundary at x≈320, gray block x≈320..511, right-edge repeat x≈512..639. Paired diagnosis converged: CoralReef #9400 identified `VdpTop.scala:888` `hCounter.resize(9)` produces modulo-512 indexing instead of modulo-320, causing out-of-bounds `readAsync` on `planeMems` (slot 10..15, depth=10) → garbage/gray; BrightForge #9401 independently verified the mechanism against `cf5722e` HDL; CyanPeak #9403 concurs. PM #9402 authorized Option C: sim-only discriminator first, then one-line HDL fix `(hCounter % U(PLANE_PIXELS)).resize(9)`, then synth/flash/capture proof. Task 31 scroll-table dependency remains historical/closed context (`ac3fb87`) — not a separate active lane.

### Packet A Milestone — Task 1 Phases 1–4 + LIVE_MODE wire

| Field | Value |
|---|---|
| **Task** | Task 1 Packet A — MODE_SELECT Phases 1–4 + LIVE_MODE wire |
| **Status** | **DONE** — CyanPeak audit PASS #9180 |
| **Phase** | closed (sub-milestone) |
| **Owner** | BrightForge (coding + proof), CyanPeak (audit PASS), CoralReef (ledger sync) |
| **Commit** | `44efb16` (+715/−38, 12 files) |
| **Latest Auth Mail** | #9175 (BrightForge proof packet), #9180 (CyanPeak audit PASS), #9184 (BronzeGate PM ruling) |
| **Proof** | `ModeSelectSim` 10/10 PASS; `C64AdapterSim` 5/5 PASS; `ZXSpectrumAdapterSim` 8/8 PASS; `VdpTopSim` regression PASS; 3 elab clean |

### Packet C Milestone — Task 1 Phase 5c+5d (HW Proof)

| Field | Value |
|---|---|
| **Task** | Task 1 Packet C — Phase 5c+5d (bitstream + HW proof) |
| **Status** | **DONE** — CyanPeak audit PASS #9201 |
| **Phase** | closed (final sub-milestone) |
| **Owner** | BrightForge (coding + proof), CyanPeak (audit PASS) |
| **Commit** | `cdd3877` (firmware), `9f0c22a` (ledger) |
| **Latest Auth Mail** | #9198 (BrightForge proof), #9201 (CyanPeak audit PASS) |
| **Proof** | Bitstream timing 0/0 violations; HW `freeze_count=0` over 30s capture during 7+ mode-select switches. |

### Packet B Milestone — Task 1 Phase 5a+5b + Adapter Specs

| Field | Value |
|---|---|
| **Task** | Task 1 Packet B — Phase 5a+5b (substrate wiring + sim) + Adapter Specs |
| **Status** | **DONE** — CyanPeak audit PASS #9192 |
| **Phase** | closed (sub-milestone) |
| **Owner** | BrightForge (sc70 coding), CoralReef (specs), CyanPeak (audit PASS) |
| **Commit** | `21af170` (Phase 5a+5b), `1523995` (Specs) |
| **Latest Auth Mail** | #9188 (BrightForge proof), #9189 (CoralReef specs), #9192 (CyanPeak audit PASS) |
| **Proof** | `Sc70RuntimeAdapterSim` 6/6 PASS; 5 regression sims PASS; Scenario 70 elab clean; 12/12 platform specs drafted |

### Closed Lane — Task 52

| Field | Value |
|---|---|
| **Task** | Task 52 — Per-Sprite X/Y Flip Primitive |
| **Status** | **DONE** — CyanPeak audit PASS #9126/#9127 |
| **Phase** | closed |
| **Owner** | BrightForge (coding + proof), CyanPeak (audit PASS), CoralReef (ledger sync) |
| **Latest Auth Mail** | #9127 (CyanPeak final audit PASS), #9125 (BrightForge proof packet), #9123 (BronzeGate ESP8266 correction) |

### Closed Lane — #9026

| Field | Value |
|---|---|
| **Task** | #9026 — Zero-Footprint ROM Elimination (narrowed) |
| **Status** | **DONE** — CyanPeak audit PASS #9142 |
| **Phase** | closed |
| **Owner** | BrightForge (coding + proof), CyanPeak (audit PASS), CoralReef (ledger sync) |
| **Latest Auth Mail** | #9142 (CyanPeak final audit PASS), #9139 (BrightForge proof packet), #9133 (BronzeGate unblock ruling) |

## Closed Lanes

### Task 50 — ZX Spectrum Adapter
| Field | Value |
|---|---|
| Status | **DONE** — v3.8 + E3.45 polish. Closure #8976 |
| Owner | BrightForge |

### Host-Init Sidecar Phases 1–3
| Field | Value |
|---|---|
| Status | **DONE** — Phase 1 causality (#9001); Phase 2 SDRAM upload (#9010); Phase 3 palette upload (#9022) |
| Owner | BrightForge |

### Platform VDP Spec Canonicalization (#9036)
| Field | Value |
|---|---|
| Status | **CLOSED** — All 12 specs converged. Round 2 complete. Index synced #9074 |
| Owner | CoralReef (index + 4 specs + 4 patches), BrightForge (4 specs), CyanPeak (4 specs) |

### Phase 1 proof summary (BrightForge #9000, CyanPeak #9001)

| Claim | Status | Evidence |
|---|---|---|
| FPGA bootstrap bypassed | ✅ **PROVEN** | `useHostInit=true` → `bootDoneR=1` from boot; gen-verified; bitstream flashed |
| Host executes init sequence | ✅ **PROVEN** | ESP8266 serial log: 220 copper uploads + 9 registers + "init complete" |
| FPGA drives live video | ✅ **PROVEN** | RTSP capture non-black; mean 115.59/255 |
| Host **caused** the displayed scene | ✅ **PROVEN** | Live toggle: 7 edges / 26 frames, 2.000s square wave, mean 110↔5, dark 6%↔96%, zero drift |

### Phase 2 proof summary (BrightForge #9009, CyanPeak #9010)

| Claim | Status | Evidence |
|---|---|---|
| Host uploads SDRAM data | ✅ **PROVEN** | `vdp_sdram_write()` opcode `0x02` implemented in sketch; 8 rows × 80 bytes bitmap + attr uploaded |
| FPGA accepts SDRAM_WRITE | ✅ **PROVEN** | `skipSdramInit=true` bypasses internal init; `QspiSdramBridge` writes to SDRAM |
| Host data drives display | ✅ **PROVEN** | Signature rows 20–27 (HDMI lines 40–55) show `0xAA`/`0x55` vertical stripes; std 42.5 vs uninitialized neighbor std 79.2 |
| Phase 1 continuity | ✅ **PRESERVED** | Live toggle still works: 2.000s square wave, mean 110↔5 |

### Phase 3 proof summary (BrightForge #9022)

| Claim | Status | Evidence |
|---|---|---|
| Host uploads palette | ✅ **PROVEN** | `vdp_palette_write_entry()` + `sc45_host_palette_upload()` — 256× `0x0600` writes for 128 entries |
| FPGA uses host palette | ✅ **PROVEN** | Bright phase R-dominant (R=140, G=118, B=113) vs default Spectrum cyan/magenta/yellow. Off phase shows grayscale ramp. |
| Phase 1+2 continuity | ✅ **PRESERVED** | Live toggle: 2.000s square wave, mean 110↔5. Phase 2 signature still visible. |
| Zero RTL change | ✅ **PROVEN** | Existing `0x0600`/`0x0601` register interface used as-is; no SpinalHDL modifications |

### Phase 1 blockers resolved

| Blocker | Resolution |
|---|---|
| ESP32-C3 v0.3 silicon fault | **CONFIRMED bad silicon** (#8985). Deprecated engineering sample. Path abandoned. |
| Classic ESP32 wiring/bootloop | **RESOLVED** (#8987–8992). Strap-safe remap, clean flash. |
| ESP8266 NodeMCU host path | **PROVEN** (#8993–9000). Full init + live toggle, end-to-end causality established. |

### Next discriminator

**None** — Phase 1 closed. Phase 2 (SDRAM data upload) and Phase 3 (ROM elimination) remain deferred per BronzeGate #8979.

**Previous lane:** Task 50 ZX Spectrum Adapter v2 — Implementation | DONE | `99e6260` | Audit PASS #8681

**Previous lane:** Task 50 ZX Spectrum Adapter v1 — Implementation | DONE | `477bf24` | Audit PASS #8674

**Previous lane:** Beam-Driven Automation Hardening — Implementation | DONE | `6345fcc` | Audit PASS #8660, BH-1/2/3/4/5/6 all proven, sc60 HW evidence

**Previous lane:** Color/Window Hardening — Implementation | DONE | `0f5dc65` | Audit PASS #8654, CW-1/2/3/4/5/6 all proven, sc51+sc52 HW evidence

**Previous lane:** Sprite Phase 2 + Phase 2-bis — Implementation | DONE | `39a7242` | Audit PASS #8625 / #8638

**Previous lane:** Sprite Pattern Memory Foundation — Implementation | DONE | `e86fe49` | Audit PASS #8605

**Artifact file:** `PROJECT_PLAN/archive/artifacts/TASK_BEAM_HARDENING.md` (v1.0, audit PASS #8656)

Rules:
- Only **one** lane may be live at a time.
- When the lane changes, update this block in the **same commit** as the artifact/state change.
- Phase values: `artifact`, `audit`, `implement`, `capture`, `closeout`.

---

## Sidecar Lanes

Sidecar lanes run in parallel with the active FPGA lane but do not block it.

### ESP32-C3 Smoke-Port (#8759)

| Field | Value |
|---|---|
| **Task** | ESP32-C3 host smoke-port for Tang QSPI control |
| **Status** | IN-PROGRESS |
| **Owner** | BrightForge |
| **Latest Auth Mail** | #8774 (boot/run proven locally — serial toggle loop visible) |
| **Uncommitted** | `firmware/esp32c3_qspi_smoke/esp32c3_qspi_smoke.ino` |
| **Next Deliverable** | Tang-side visible proof: `REG_WRITE` toggle must change HDMI output on a sprite-rendering bitstream |
| **Coding Authorized** | YES — #8765 |

**Boot config:** `FlashMode=dio`, `CDCOnBoot=cdc` required for stable boot + host serial.

**Host-side proof:** Serial shows repeating `LAYER_ENABLE=0x0007` / `0x0003` toggle every 2s.

**Scope boundary:** Minimum viable smoke only. No `vdp_read_status`, no `vdp_sdram_write`, no full libvdp parity.

---

## Current Baseline

The repository has closed the Mode0 substrate backlog through baseline **`32a87ff`**:

- **R1** — Raster Trigger Unit (`df7af63`)
- **R2** — Two-Pass Sprite Evaluator
- **R3** — Static Fetch-Slot Scheduler
- **R4** — Tile + Attribute Fetch Primitive (`df7af63`)
- **R4.1** — Multi-Slot Scheduler Coupling (`9dfeb9f`)
- **R4.1b** — Planar Fetch Path
- **R4.1c** — Packed-Attribute Decode (`0e4d9dc`)
- **R5** — Host Interface + Copper Coprocessor
- **R5.3** — Copper Control Unification (`32a87ff`)
- **R5.4** — Scroll-Wrap Component Primitive (`d580dcb`)

That means Tasks 1 through 5, Task 15, Task 16, Task 18, Task 26, Task 27, and Tasks 34, 35, 38a, 38b, 38c, and 39 are already complete in this repo state.

---

## Phase 1 — Output Bring-Up

### Task 1 — Tang20K Project Skeleton

**Status:** DONE
**depends_on:** none
**scope_boundary:** No claim beyond a buildable repository skeleton and board flow.
**delivers:**

- `build.sbt` and SBT project configuration
- initial SpinalHDL package under `hw/spinal/spinalhdlvdp/`
- Tang Nano 20K build flow under `fpga/tang20k/`
- Gowin project Tcl and constraints that accept generated Verilog

**validation:** SBT generation succeeds and Gowin accepts the generated top-level.

### Task 2 — Clocking and Reset Bring-Up

**Status:** DONE
**depends_on:** [1]
**scope_boundary:** No feature work beyond stable board clocks, reset, and basic board visibility.
**delivers:**

- PLL instantiation for board clocking
- pixel clock divider path
- reset behavior tied to PLL lock
- LED observability in the top-level wrapper

**validation:** Hardware shows stable board activity and the synthesized design is free of clock/reset build errors.

### Task 3 — Video Timing Generator

**Status:** DONE
**depends_on:** [2]
**scope_boundary:** No memory-backed rendering. Timing generation only.
**delivers:**

- visible-raster timing in `VdpTop.scala`
- active video, sync, and coordinate outputs
- simulation coverage in `VdpTopSim.scala`

**validation:** Simulation confirms timing-driven coordinates and active pixel behavior for the current 640x480 pattern generator.

### Task 4 — TMDS / Video Output Path

**Status:** DONE
**depends_on:** [2, 3]
**scope_boundary:** No external-memory rendering. Output transport only.
**delivers:**

- TMDS transport wrapper
- vendor serializer / LVDS output path
- HDMI output driven from the SpinalHDL pixel source

**validation:** HDMI capture locks to the signal and remains stable without sync loss.

### Task 5 — Solid Color / Test Pattern Output

**Status:** DONE
**depends_on:** [3, 4]
**scope_boundary:** No tile/sprite/palette/memory-backed rendering.
**delivers:**

- direct coordinate-driven visible pattern
- stable hardware output suitable as a bring-up baseline
- simulation and hardware evidence for the same pattern

**validation:** Current hardware output shows the intended red / green / blue / yellow quadrant pattern with white grid, border, and cross, and remains stable under direct capture.

---

## Phase 2 — Core Mode0 Pixel Control

### Task 6 — Basic Pattern Source

**Status:** DONE
**depends_on:** [5]
**scope_boundary:** No SDRAM. No scrolling. No sprites. Single deterministic on-chip pattern source only.
**delivers:**

- on-chip pattern or tile source stored in local memory
- pixel fetch path that no longer depends purely on combinational quadrant logic
- visible deterministic pattern on hardware

**validation:** Hardware output is stable and matches simulation for the same pattern source.

### Task 7 — Scroll Path

**Status:** DONE
**depends_on:** [6]
**scope_boundary:** Single layer only. No seam validation beyond local movement. No sprites. No multi-layer composition.
**delivers:**

- X and Y scroll offsets
- address generation applying scroll offsets to the pattern source
- visible motion under scroll updates

**validation:** Motion is stable, deterministic, and free of obvious addressing artifacts.

### Task 8 — Wraparound / Seam Correctness

**Status:** DONE
**depends_on:** [7]
**scope_boundary:** Single layer only. Boundary-correctness work only.
**delivers:**

- correct wraparound behavior at tilemap or pattern boundaries
- no visible seam at the wrap point

**validation:** Boundary crossing shows no visible discontinuity on hardware.

### Task 9 — Line Buffer Implementation

**Status:** DONE
**depends_on:** [5]
**scope_boundary:** No sprites. No palette lookup yet. No feature expansion beyond replacing the direct pixel path with a buffered path.
**delivers:**

- line buffer storage
- fill/drain handoff logic
- output path preserved through buffered readout

**validation:** Buffered output is visually equivalent to the current direct test-pattern baseline.

### Task 10 — Palette Path

**Status:** DONE
**depends_on:** [9]
**scope_boundary:** Single palette only. No palette animation. No sprite-specific palette rules.
**delivers:**

- palette memory
- indexed pixel to RGB lookup
- test palette contents with visible proof on hardware

**validation:** Hardware colors match the programmed palette entries with no new corruption.

---

## Phase 3 — Core Mode0 Object Rendering

### Task 11 — Sprite Pipeline

**Status:** DONE
**depends_on:** [9, 10]
**scope_boundary:** No SDRAM. Single-sprite proof only. No affine. No scaling.
**delivers:**

- sprite attribute storage
- per-line active-sprite evaluation
- sprite pixel fetch and injection into the current render path

**validation:** A single sprite renders correctly over a static background and moves correctly.

### Task 12 — Sprite Priority / Transparency

**Status:** DONE
**depends_on:** [11, 13]
**scope_boundary:** Priority and transparency only. No affine. No scaling.
**delivers:**

- transparent pixel handling
- sprite/background priority resolution
- multi-sprite ordering behavior

**validation:** Transparent regions and overlap ordering behave correctly on hardware.

---

## Phase 4 — Core Mode0 Composition

### Task 13 — Multi-Layer Composition

**Status:** DONE
**depends_on:** [9, 10]
**scope_boundary:** Background layers only. No sprites in this task. No linestate. No SDRAM.
**delivers:**

- multi-input compositor for background layers
- deterministic priority handling
- combined output path compatible with the current timing/output baseline

**validation:** Multiple visible layers compose correctly with stable hardware output.

---

## Phase 5 — Core Mode0 Memory-Driven Rendering

---

### Task 14 — Linestate Model

**Status:** DONE
**depends_on:** [9, 13]
**scope_boundary:** No raster effects yet. Linestate commit at line boundary only. No SDRAM. Linestate records stored on-chip.
**delivers:**

- Linestate record definition (per `GLOSSARY.md`)
- Double-buffered linestate store: prepare side writable by host, commit side readable by render pipeline
- Atomic commit at line boundary
- Render pipeline reads linestate from commit side only

**validation:** Linestate values apply correctly at line boundaries in simulation. No mid-line state change visible.

---

### Task 15 — Memory-Backed Fetch Path

**Status:** DONE
**depends_on:** [6, 14]
**scope_boundary:** Tile fetch from SDRAM only. No planar. No shuffled. No sprite SDRAM fetch yet.
**note:** Delivered by **R4 — Tile + Attribute Fetch Primitive** (`df7af63`).
**delivers:**

- SDRAM controller in Tang20K wrapper
- SDRAM arbiter accepting fetch requests
- Tile fetch engine requesting and receiving data from SDRAM
- Rendered output driven from SDRAM-backed tile data

**validation:** Tile data fetched from SDRAM renders correctly on hardware. Fetch timing is stable under continuous operation.

---

### Task 16 — Planar Fetch Path

**Status:** DONE
**depends_on:** [15]
**scope_boundary:** Planar background fetch only. No shuffled. No sprite path changes.
**note:** Delivered by **R4.1b — Planar Fetch** (closed).
**delivers:**

- Planar fetch engine reading multi-bitplane data from SDRAM
- Pixel index reconstructed from bitplane data
- Planar scene rendered on hardware

**validation:** Planar bitmap scene (Scenario 9) passes on hardware.

---

### Task 17 — Shuffled Fetch Path

**Status:** DONE
**depends_on:** [15]
**scope_boundary:** Shuffled background fetch only. No planar changes.
**note:** Planned as **R4.1d — Shuffled Fetch Path**.
**delivers:**

- Amiga-style dual-base 2bpp bitplane fetch path (Plane 0 @ `0xA000`, Plane 1 @ `0xB000`)
- Pixel reconstruction `{plane1[bit], plane0[bit]}` from separate SDRAM bases
- Bitplane-checkerboard diagnostic scene rendered on hardware

**validation:** Shuffled bitmap scene (Scenario 10) passes on hardware with 30s OpenCV stability analysis.

---

### Task 18 — Per-Line Raster Control

**Status:** DONE
**depends_on:** [14]
**scope_boundary:** Raster effects driven by linestate only. No affine. No color math yet.
**note:** Delivered by **R1 — Raster Trigger Unit** (`df7af63`).
**delivers:**

- Per-line scroll variation (different scroll offset per scanline)
- Per-line layer enable/disable
- Visible raster effect on hardware

**validation:** Raster effects scenario (Scenario 11) passes on hardware. No stepping or scheduling artifacts.

---

## Phase 6 — Advanced Mode0 Functions

---

### Task 19 — Affine Layer

**Status:** DONE
**depends_on:** [15, 18]
**scope_boundary:** Affine background only. No affine sprites. No scaling beyond what the affine matrix provides.
**delivers:**

- Affine coordinate stepping logic
- Affine-fetched background rendered on hardware
- Correct visual transform output

**validation:** Affine background with sprites scenario (Scenario 12) passes on hardware.

---

### Task 20 — Color Math / Window Effects

**Status:** DONE
**depends_on:** [13, 14]
**scope_boundary:** Post-compositor effects only. No changes to upstream pipeline.
**delivers:**

- Blending operation (additive or alpha, per configuration)
- Window region definition and masking
- Effect visible on hardware

**validation:** Color math / window scene (Scenario 14) passes on hardware.

---

## Phase 7 — Integration Proofs

---

### Task 21 — Mixed-Scene Integration

**Status:** DONE
**depends_on:** [15, 16, 17, 18, 19, 20]
**scope_boundary:** Integration of existing Mode0 primitives only. No new primitives.
**delivers:**

- Scene combining tile, planar, shuffled, sprite, and raster effect paths simultaneously
- Stable output with no corruption

**validation:** Mixed fetch-mode integration scene (Scenario 15) passes on hardware.

---

## Phase 8 — Integration and Stress

---

### Task 22 — Long Soak Validation

**Status:** DONE
**depends_on:** [21]
**scope_boundary:** No new features. Runtime stability testing only.
**delivers:**

- Soak test running for minimum 1 hour with continuous motion
- No drift, corruption, or instability observed

**validation:** Long soak scene (Scenario 16) passes. Zero corruption events in observation window.

---

### Task 23 — Stress-Scene Validation

**Status:** DONE
**depends_on:** [21]
**scope_boundary:** No new features. Maximum-load scenario only.
**delivers:**

- Worst-case scene: maximum active sprites, maximum layer activity, maximum fetch demand
- Stable output documented at load ceiling

**validation:** Stress scene (Scenario 17) runs stably. Load ceiling documented.

---

### Task 24 — QSPI Control Surface

**Status:** RETIRED — superseded by R5 Host Interface + Copper
**depends_on:** [14, 15]
**scope_boundary:** Control path only. No new rendering features. QSPI interface to existing registers and linestate only.
**delivers:**

- Redirected to R5. The indirect register model and command FIFO in R5 satisfy the original QSPI control-surface goal.

**validation:** See R5 task doc.

---

### Task 25 — Future Address/Data Bus Interface Definition

**Status:** DONE — artifact PASS #8322 at commit `5fb86d8`
**depends_on:** [24]
**scope_boundary:** Definition and planning only. No implementation until QSPI path is stable.
**delivers:** Design document describing parallel bus attachment strategy.

**validation:** Document reviewed and approved before implementation begins.

---

## Scenario Validation Tasks

These are not implementation tasks. Each scenario must be run against hardware and marked `DONE` only when it passes.

| # | Scenario | Depends on Tasks | Status |
|---|---|---|---|
| 26 | Scenario 1 — Static background fill | 5, 6, 10 | DONE |
| 27 | Scenario 2 — Single-axis scroll | 7, 26 | DONE |
| 28 | Scenario 3 — Scroll wraparound / seam test | 8, 27 | DONE |
| 29 | Scenario 4 — Single sprite over static background | 11, 26 | DONE |
| 30 | Scenario 5 — Four bouncing sprites over static background | 11, 29 | DONE |
| 31 | Scenario 6 — Sprites over scrolling background | 12, 13, 27, 30 | DONE |
| 32 | Scenario 7 — Sprite priority / overlap test | 12, 31 | DONE |
| 33 | Scenario 8 — Multi-layer parallax scroll | 13, 27 | DONE |
| 34 | Scenario 9 — Planar bitmap scene | 16 | DONE |
| 35 | Scenario 10 — Shuffled bitmap scene | 17 | DONE |
| 36 | Scenario 11 — Per-line raster effects | 18 | DONE |
| 37 | Scenario 12 — Affine background with sprites | 19, 12 | DONE |
| 38 | Scenario 13 — Palette animation during motion | 10, 14, 27 | DONE |
| 39 | Scenario 14 — Color math / window scene | 20 | DONE |
| 40 | Scenario 15 — Mixed fetch-mode integration scene | 21 | DONE |
| 41 | Scenario 16 — Long soak scene | 22 | DONE |
| 42 | Scenario 17 — Stress scene | 23 | DONE |

---

## R-Roadmap Execution Tasks

These tasks track the post-roadmap primitive build order defined in `MODE0_PLANNING.md` §3 (Strategic Roadmap).

### R1 — Raster Trigger Unit

**Status:** DONE  
**Task doc:** `PROJECT_PLAN/archive/tasks/TASK_R1_RASTER_TRIGGER_UNIT.md`

### R2 — Two-Pass Sprite Evaluator

**Status:** Initial primitive closed; stronger variant pending via **Task 28**  
**Task doc:** `PROJECT_PLAN/archive/tasks/TASK_R2_TWO_PASS_SPRITE_EVALUATOR.md`

### R3 — Static Fetch-Slot Scheduler

**Status:** Initial primitive closed; stronger variant pending via **Task 30**  
**Task doc:** `PROJECT_PLAN/archive/tasks/TASK_R3_FETCH_SLOT_SCHEDULER.md`

### R4 — Tile + Attribute Fetch Primitive

**Status:** CLOSED (`df7af63`)  
**Task doc:** `PROJECT_PLAN/archive/tasks/TASK_R4_TILE_ATTRIBUTE_FETCH.md`  
**Coding Owner:** BrightForge  
**Audit Owner:** CyanPeak

### R4.1 — Multi-Slot Scheduler Coupling

**Status:** CLOSED (`9dfeb9f`)  
**Task doc:** `PROJECT_PLAN/archive/tasks/TASK_R4_1_MULTI_SLOT_SCHEDULER_COUPLING.md`  
**Coding Owner:** BrightForge  
**Audit Owner:** CyanPeak

### R4.1c — Packed-Attribute Decode (NES-style)

**Status:** CLOSED (`0e4d9dc`)  
**Task doc:** `PROJECT_PLAN/archive/tasks/TASK_R4_1C_PACKED_ATTRIBUTE.md`  
**Coding Owner:** BrightForge  
**Audit Owner:** CyanPeak

**Note:** Stages 1-4 audited and passed (`4290b86`). Stage 5 re-delivered with a packed-friendly diagnostic attribute map (`0xE4`/`0xEC`) producing an unambiguous 2×2 bank-checkerboard (banks 0/1/2/3 from a single shared SDRAM byte) on Tang Nano 20K HDMI capture. All 11 sims pass. 100% verification rule satisfied.

### R4.1d — Shuffled Fetch Path (Amiga-style)

**Status:** CLOSED (`0087920`)  
**Task doc:** `PROJECT_PLAN/archive/tasks/TASK_R4_1D_SHUFFLED_FETCH.md`  
**Coding Owner:** BrightForge  
**Audit Owner:** CyanPeak

**Checkpoint A:** COMPLETE / AUDIT-PASSED (`8a86f31`) — `VDP_TILE_MODE @ 0x0311` widened 1→2 bits, `UnifiedRegMapSim` case 4c/4d proves safe-boundary commit.  
**Checkpoint B:** COMPLETE / AUDIT-PASSED (`db6b933`) — dual-base fetch path implemented, `TileAttributeFetchSim` case 9 proves bit-accurate reconstruction, all 11 sims PASS.  
**Checkpoint C:** COMPLETE (`0087920`) — bitplane-checkerboard diagnostic scene rendered on Tang Nano 20K; 30s OpenCV analysis shows four distinct intensity bands (~25% each) with 0 spikes / 0 freezes; all 11 sims PASS.

### R5 — Host Interface + Copper Coprocessor

**Status:** CLOSED (`32a87ff`) — initial host interface + Copper primitive  
**Task doc:** `PROJECT_PLAN/archive/tasks/TASK_R5_HOST_INTERFACE_AND_COPPER.md`  
**Coding Owner:** BrightForge  
**Audit Owner:** CyanPeak

**Note:** Register bus spec (R5.1) and Copper-lite automation (R5.2) remain open via **Tasks 32a** and **33**.

### R5.3 — Copper Control Unification (`VDP_CTRL` register)

**Status:** CLOSED (`32a87ff`)  
**Task doc:** `PROJECT_PLAN/archive/tasks/TASK_R5_3_COPPER_CTRL_UNIFICATION.md`  
**Coding Owner:** BrightForge  
**Audit Owner:** CyanPeak

### R5.4 — Scroll-Wrap Component Primitive

**Status:** CLOSED (`d580dcb`)  
**Task doc:** `PROJECT_PLAN/archive/tasks/TASK_R5_4_SCROLL_WRAP.md`  
**Coding Owner:** BrightForge  
**Audit Owner:** CyanPeak

### R6 — Color Math / Window Effects

**Status:** CLOSED (`dd119ec`)  
**Task doc:** `PROJECT_PLAN/archive/tasks/TASK_20_COLOR_MATH_WINDOW.md`  
**Coding Owner:** BrightForge  
**Audit Owner:** CyanPeak

---

## Phase 9 — Host Control

---

### Task 26 — QSPI Host-Control Frontend

**Status:** DONE
**depends_on:** [23]
**scope_boundary:** Transport shim and decoder only. No bulk asset streaming, no protocol expansion, no new rendering primitives, no FIFO model redesign.
**delivers:**

- QSPI slave transport shim (SpinalHDL port of proven `m0_qspi_slave.v`)
- QSPI command decoder mapping register writes into existing `VdpTop.io.regWrite*` contract
- READ_STATUS response mux for host bring-up diagnostics
- Pico 2 smoke firmware proving the path
- Hardware proof: QSPI-driven register write visibly toggles output

**validation:**

- Checkpoint A: control contract + clean Verilog + pin mapping (PASSED at `df0b75b`)
- Checkpoint B: simulation proofs + READ_STATUS mux (PASSED at `8c4f165`)
- Checkpoint C: Pico 2 smoke test + `LAYER_ENABLE` live-update on hardware

**debug history:**

- `2138a27`: Amended firmware toggle `0x0000 <-> 0x0005`; 30 s capture FAIL — no visible change.
- `04d488b`: Forward wire-test (Pico drives, FPGA samples via LEDs) — committed, awaiting user observation.
- `1541615`: Reverse wire-test (FPGA drives, Pico reads via serial) — **all 4 wires PASS**. Physical wiring proven correct.
- `1541615`: 2 MHz retest — FAIL (same flat signature). SCK rate ruled out.
- `7512`: Architectural gap identified — top-level QSPI IO pins are input-only; `IOBUF` bidirectional work deferred.
- `7513`: BronzeGate direction — execute **Option B** (LED write-direction probe) first. Bounded scope, no `IOBUF`.
- `7516`–`7518`: Option B/B2 executed — `active` and `cmd_valid` pulse, but `regWriteEnable` NEVER pulses.
- `7517`–`7519`: BronzeGate authorized iterations B2, B3.
- `7520`: BronzeGate direction — HDMI debug HUD preferred over LED-only.
- **`7527` (BrightForge PRIMARY root cause):** HUD-v2 shows `payload_cnt / cmd_cnt = 1.000` — only 1 payload byte arrives per command instead of 2. Pico firmware `qspi_tx_bytes` polls `tx_fifo_empty` then `sleep_us(2)`, but CS is deasserted before the SM finishes shifting the last word from OSR. **Fix 1:** `sleep_us(10)` in `befcd17`.
- **`7531` (Checkpoint C PASS):** Fix 1 applied. Post-fix evidence: `payload_cnt/cmd_cnt = 2.000`, `regWriteEnable` duty = 20.1%, luma bimodal gap = 144.01. Hardware proof complete.
- **`7534` (CyanPeak audit):** Checkpoint C formally PASSED. Fix 2 (IO2/IO3 wiring) DEFERRED to separate hardening lane. BrightForge authorized to revert debug artifacts (HUD/LED probes).
- **`7526` (CoralReef SECONDARY issue):** spinalhdlVDP CST only wires IO0+IO1. PIO quad-mode sends 4 bits/nibble; FPGA ties IO2/IO3 to 0. Data bytes with bits 2/3 set in any nibble are corrupted (e.g. `0x05` → `0x01`). Verified by corrected `Qspi2WireSimV2`. Does NOT block Checkpoint C (opcode `0x01` correct, 2 payload bytes arrive with Fix 1, `regWriteEnable` fires). Fix deferred.

**Task doc:** `PROJECT_PLAN/archive/QSPI_HOST_CONTROL_PLAN.md`

---

### Task 27 — Full-QSPI Hardening (IO2/IO3)

**Status:** DONE
**depends_on:** [26]
**scope_boundary:** IO2/IO3 wiring + CST + hardware proof of 4-bit payload fidelity only. No protocol redesign, no bulk asset streaming, no readback/bidirectional work unless explicitly added.
**delivers:**

- Tang CST updated with IO2 (pin 51) and IO3 (pin 54) per proven VDP project pinout
- `TopTang20kHdmi` updated to connect all 4 QSPI data lines (remove `B"00" ## ...` tie-off)
- Simulation proof that 4-bit payload bytes (nibbles with bits 2/3 set) are received correctly
- Hardware proof: QSPI-driven register write with payload value exercising bit 2 (`0x0007`) visibly toggles on Tang Nano 20K

**validation:**

- Checkpoint A: HDL + CST update, clean Verilog generation, P&R passes — **LANDED `1794c9c`, regression verified**
- Checkpoint B: simulation proof with payload bytes containing bits 2/3 set — **LANDED `494e037`, 7 cases PASS (0xFFFF, 0xAAAA, 0x5555, 0xBEEF, 0x00F3)**
- Checkpoint C: hardware proof on Tang Nano 20K — **LANDED `92ecb41`, LAYER_ENABLE toggle `0x0007 ↔ 0x0000` visible, bimodal gap = 153.07**

**Post-completion notes (BrightForge #7566):**
- Bit 3 observability gap: no current Mode0 register maps bit 3 to visible pixel feature. Bit 3 is sim-proven (rides same IO3 wire as bit 2) but hardware eyeball confirmation requires readback path or diagnostic probe.
- Physical jumper map (GP8–GP13 ↔ Tang 41/42/48/49/51/54) should be captured in `PLATFORM.md`.
- PIO TX drain gotcha (`sleep_us(2)` insufficient) should be hardened to true SM-idle poll in future firmware.
- `rx_cmd_cnt` / `last_addr` / `last_data` / `last_error` should be promoted to READ_STATUS surface in Task 38.

**Task doc:** `PROJECT_PLAN/TASK27_FULL_QSPI_HARDENING.md` (artifact doc opened in `cc7ec82`, CyanPeak audit PASS in #7548)

---

### Task 28 — Two-Pass Sprite Evaluator

**Status:** DONE (`9e07804`)
**depends_on:** [12, 15]
**scope_boundary:** Sprite evaluation pipeline only. No new compositor changes, no collision logic (Task 29), no attribute extension (Task 37).
**delivers:**

- Per-line active-sprite scan with bounded visible-sprite selection
- Sprite-per-scanline limit enforcement
- Secondary sprite buffer for fetched attributes
- Stronger overlap/priority behavior

**validation:**

- Sim: mixed scene with >8 sprites on a line proves correct selection and limit enforcement
- Hardware: visual proof on Tang Nano 20K that sprite drop behavior matches expected limits

**Task doc:** `PROJECT_PLAN/archive/tasks/TASK_R2_TWO_PASS_SPRITE_EVALUATOR.md`

---

### Task 29 — Sprite Flags and Collision Hooks

**Status:** DONE (`ad9857e`)
**depends_on:** [28]
**scope_boundary:** Sprite-side status flags only. No new compositor, no new fetch formats.
**delivers:**

- Sprite-0-hit style flag (first non-transparent sprite pixel vs background)
- Per-line sprite overflow/limit status register
- Sprite/background collision latches
- Clearer priority-vs-layer hooks

**validation:**

- Sim: collision scenarios produce correct latch values
- Hardware: raster-IRQ or status-read path proves flags are visible to host

---

### Task 30 — Pre-Announced Arbiter Grant

**Status:** DONE (`734ffb6`)
**depends_on:** [15]
**scope_boundary:** SDRAM arbitration lookahead only. No new fetch engines, no new memory types.
**delivers:**

- BA-style lookahead so fetch clients can prepare before the exact memory-use slot
- More deterministic multi-fetch scenes
- Latency-tolerant SDRAM arbitration

**validation:**

- Sim: mixed scene with tile + sprite + Copper fetch proves no arbitration glitches under lookahead
- Hardware: long-soak validation (Task 22 class) with arbiter active

**Task doc:** `PROJECT_PLAN/archive/tasks/TASK_30_PRE_ANNOUNCED_ARBITER_GRANT.md`

---

### Task 31 — Scroll Table Primitive

**Status:** DONE (`ac3fb87`)
**depends_on:** [7, 15]
**scope_boundary:** Scroll tables only. No new tile fetch formats, no new compositor math.
**delivers:**

- Separate small dual-port RAM/table primitive for per-column or per-band scroll
- Explicit distinction between line state and scroll lookup state
- Interface for Genesis VSRAM-style patterns and SNES offset-per-tile

**validation:**

- Sim: scene with per-column scroll offsets proves correct addressing
- Hardware: visible parallax effect on Tang Nano 20K

**Task doc:** `PROJECT_PLAN/archive/tasks/TASK_31_SCROLL_TABLE_PRIMITIVE.md`

---

### Task 32a — Mode0 Register Bus: Spec & Naming Lock

**Status:** DONE
**depends_on:** [18, 26]
**scope_boundary:** Register bus specification and naming lock only. No master refactor, no new primitives, no adapter-specific registers.
**delivers:**

- Written register bus specification (address map, semantics, naming convention)
- Uniform naming and ownership pattern for all existing control/status surfaces
- Interface contract that bootstrap, QSPI, Copper, and Animator masters can target
- Semantics sketch that earlier primitives (R1-R4) can absorb without breakage

**validation:**

- Doc review: bus spec covers all existing primitives plus planned R5-R8
- Sim: register writes via QSPI correctly propagate through the bus to all targets

---

### Task 32b — Mode0 Register Bus: Master Refactor

**Status:** DONE
**depends_on:** [32a]
**scope_boundary:** Refactor existing masters to the named bus. No new primitives.
**delivers:**

- Bootstrap write path, QSPI `regWriteEnable` mux, copper RAM writes, animator writes, linestate prepare/commit, affine register set, and all existing control surfaces refactored onto the named bus
- All existing simulations pass after refactor

**validation:**

- Sim: all existing scenario simulations pass with zero behavioral change
- Hardware: at least one existing scenario re-proven on Tang Nano 20K

---

### Task 33 — Copper-lite / HDMA Automator

**Status:** DONE
**depends_on:** [32a]
**scope_boundary:** Beam-synchronous micro-engine only. No new fetch engines, no new output stages.
**delivers:**

- Wait-for-beam-position + write-selected-register engine
- Optional table-driven value reload
- Palette-bank or palette-entry reload actions
- Amiga Copper-style wait/move and SNES HDMA-style per-line updates

**validation:**

- Sim: copper script produces expected raster splits and color bars
- Hardware: visible raster effects on Tang Nano 20K

---

### Task 34 — QSPI Host-Driven Asset Upload

**Status:** DONE
**depends_on:** [27, 38c]
**scope_boundary:** Bulk SDRAM write via QSPI only. No new rendering primitives, no protocol redesign.
**delivers:**

- QSPI command path for writing SDRAM directly (textures, tilemaps, tile rows, palette entries/banks)
- Addressed burst write protocol with progress/status
- Hardware proof: upload a small texture/tileset and palette entry/bank via QSPI and render it

**validation:**

- Sim: QSPI burst write lands in SDRAM model, fetched data matches
- Hardware: uploaded asset renders correctly on Tang Nano 20K

---

### Task 35 — Host-Facing IRQ and Status Registers

**Status:** DONE
**depends_on:** [18, 32a]
**scope_boundary:** IRQ line + readable status register surface only. No new automation engines.
**delivers:**

- Host-visible raster match / IRQ line
- Sticky status registers (sprite overflow, raster match, QSPI ready, etc.)
- Clear-on-read or write-to-clear semantics
- Status readable under maximum fetch load (not just idle)

**validation:**

- Sim: raster trigger asserts IRQ, host readback sees correct status
- Sim: status read is stable under concurrent SDRAM fetch + sprite evaluation load
- Hardware: Pico reads status register over QSPI and prints expected values

---

### Task 36 — Register Write Concurrency Stress Test

**Status:** DONE
**depends_on:** [26, 33]
**scope_boundary:** Validation-only task. No new HDL, no new firmware features.
**delivers:**

- Sim scenario with QSPI + Copper + Animator all writing registers on the same frame
- Proof that safe-boundary commit absorbs concurrent writes without glitches
- Explicit bandwidth analysis under maximum write traffic
- Multi-master bus stress under maximum SDRAM fetch + sprite evaluation load

**validation:**

- Sim: 10k-frame randomized stress with all three masters → zero commit glitches
- Sim: status readback is correct while masters are actively writing
- Hardware: rapid alternating writes from QSPI and Copper → visual stability

---

### Task 37 — Affine Sprite Path

**Status:** DONE (`e4e53bc`)
**depends_on:** [19, 28]
**scope_boundary:** Affine-transformed sprites only. No new background affine features.
**delivers:**

- Matrix-stepped texture address generation for sprite source data
- Rotation/scaling support for individual sprites
- Integration with existing sprite evaluator and compositor

**validation:**

- Sim: affine sprite renders with correct transformed pixels
- Hardware: visible rotated/scaled sprite on Tang Nano 20K

**Task doc:** `PROJECT_PLAN/archive/tasks/TASK_37_AFFINE_SPRITE_PATH.md`

---

### Task 38a — Bidirectional QSPI: HDL IOBUF + CST

**Status:** DONE (`f49880f`)
**depends_on:** [27]
**scope_boundary:** Top-level bidirectional wiring only. No decoder changes, no firmware.
**delivers:**

- Gowin `IOBUF` primitive on IO0/IO1/IO2/IO3 in `TopTang20kHdmi`
- CST updated: pins 48/49/51/54 become bidirectional (pull-modes revisited)
- `QspiSlave` Respond state drives valid data back to host
- Clean Verilog generation, P&R passes

**validation:**

- Sim: `READ_STATUS` command drives valid response data onto IO pins
- Hardware: synthesis and place-and-route succeed without errors

---

### Task 38b — Bidirectional QSPI: Status Surface Expansion

**Status:** DONE (`1294614`)
**depends_on:** [38a]
**scope_boundary:** Decoder status surface only. No firmware, no IOBUF changes.
**delivers:**

- READ_STATUS response surface expanded beyond magic `sel=0`
- `sel=1`: `rx_cmd_cnt`
- `sel=2`: `last_addr`
- `sel=3`: `last_data`
- `sel=4`: `last_error`
- Sim proof that all sel values return expected fields

**validation:**

- Sim: `READ_STATUS` with sel=0..4 returns expected values
- Hardware: high-nibble bits (e.g. `0x51` in response bytes) confirm IO3 path is electrically alive

---

### Task 38c — Bidirectional QSPI: Firmware Read Helper + Bit-3 Proof

**Status:** DONE (`4cee22e`)
**depends_on:** [38b]
**scope_boundary:** Firmware read path only. No HDL changes.
**delivers:**

- Pico firmware QSPI read helper (proven reference available in `/home/itadmin/github/VDP/src/mode0/firmware/src/qspi_bus.c`)
- Firmware reads magic `0x51560002` and status registers (`rx_cmd_cnt`, `last_addr`, `last_data`, `last_error`)
- `pio_wait_sm_idle()` drain helper replacing ad-hoc `sleep_us(10)` margin
- Bit-3 hardware observability: high-nibble status bytes confirm IO3 path

**validation:**

- Hardware: Pico receives `0x51560002` on Tang Nano 20K over QSPI readback
- Hardware: high-nibble bits are not silently zeroed (bit-3 alive proof)

---

### Task 39 — Host Driver Library

**Status:** DONE (`684e3dd`)
**depends_on:** [34, 35, 38c]
**scope_boundary:** Host-side library only. No HDL changes, no new rendering primitives.
**delivers:**

- `libvdp_mode0_host.{c,h}` — firmware-agnostic driver above QSPI transport
- Packet framing, register map abstraction, status polling helpers
- Asset upload protocol with burst + progress callbacks
- IRQ handling hooks
- Reusable `pio_wait_sm_idle()` drain helper

**validation:**

- Firmware builds and links against the library with zero warnings
- Hardware: library-driven upload + register write + status read cycle proves end-to-end host control

---

### Task 40 — First Platform Adapter (C64 Raster+Sprite Smoke)

**Status:** DONE — implementation PASS #8298 at commit `6e93888`; artifact §7 amended at `81b809a`
**depends_on:** [29, 30, 39, 44]
**scope_boundary:** Deferred platform-specific proof only. Do not open until broad Mode0 substrate tasks are complete enough to support multiple adapters. No cycle-accurate emulation claim. No additional platforms.
**delivers:**

- C64-class raster IRQ driving a two-bar split with sprites
- Register semantics and control model matching C64-style behavior
- Honest "first real adapter on top of Mode0" milestone
- Proof that the substrate contract works in real use

**validation:**

- Sim: adapter register writes produce expected C64-class raster split
- Hardware: visible two-bar split + sprite behavior on Tang Nano 20K
- 30s capture stability analysis passes

**Task doc:** To be created when lane opens.

---

### Task 41 — Compositor Metadata Pipe

**Status:** DONE
**depends_on:** [13]
**scope_boundary:** Metadata pipe definition and wiring only. No new compositor math, no new fetch formats.
**delivers:**

- Per-pixel metadata flag definition (math-enable, forced-priority, layer-source)
- Metadata carried through line-buffer boundary
- Compositor consumes metadata flags for color-math and priority decisions
- Explicit contract between fetch engines and post-compositor stages

**validation:**

- Sim: metadata flags generated by fetch engine arrive at compositor intact
- Hardware: visible proof that metadata-driven effects (e.g. forced-priority sprite) behave correctly

---

### Task 42 — Firmware + Platform Docs Hardening

**Status:** DONE
**depends_on:** [27]
**scope_boundary:** Documentation and small firmware helpers only. No HDL changes.
**delivers:**

- Six-wire Pico↔Tang jumper map captured in `PLATFORM.md`
- Reusable `pio_wait_sm_idle()` PIO drain helper (if not delivered by Task 39)
- Documented QSPI firmware gotchas and workarounds
- PIO timing constraints and verified SCK rates documented

**validation:**

- Doc review: PLATFORM.md is complete and accurate for current hardware setup
- Firmware: drain helper tested in isolation and integrated into smoke test

---

### Task 43 — Scenario Regression Harness

**Status:** DONE
**depends_on:** [21]
**scope_boundary:** Test infrastructure only. No new HDL, no new features.
**delivers:**

- Regression script/Makefile target that rebuilds and tags scenario bitstreams 1–17
- Capture + analysis artifact preservation policy
- Automated stability check (OpenCV/FFT-based) for each scenario
- CI-friendly entry point for post-substrate-change validation

**validation:**

- All 17 scenarios rebuild successfully from clean state
- At least 3 representative scenarios pass automated stability analysis

---

## Phase 9.5 — Mode0 Adapter-Readiness Hardening

Platform adapters are now treated as a **new stage**.

Current roadmap direction: do **not** start platform-specific adapter lanes yet.
Close the broad, reusable Mode0 substrate capabilities first so future
platform adapters build on shared primitives instead of one-off platform code.

Do not open an adapter lane until both are true:

- the documentation/usability gate has passed for the current Mode0 substrate
- the substrate gaps required by the chosen platform have been explicitly closed

**Closed hardening lanes (not numbered in original task sequence):**

### Hardening Lane — Mode0 Fetch Envelope Hardening

**Status:** DONE
**depends_on:** [17, 32a, 43]
**scope_boundary:** Strengthen planar, shuffled, and bitmap fetch paths for adapter readiness. No adapter-specific register maps.
**delivers:**

- Gap analysis of planar fetch vs. Amiga/ST pressure
- Gap analysis of shuffled/bitmap+attribute fetch vs. ZX Spectrum pressure
- Strengthened fetch paths still within `MODE0_PLANNING.md` §2 (Resource Stop-Lines)

**validation:** Hardware proof on Tang Nano 20K; all existing regressions pass.

### Hardening Lane — Mode0 Sprite Envelope Hardening

**Status:** DONE (`d44a9c0`)
**depends_on:** [28, 29, 30]
**scope_boundary:** Strengthen sprite descriptor envelope and pattern memory. No platform-exact sprite semantics.
**delivers:**

- Expanded sprite descriptor fields
- Strengthened visibility/priority/metadata envelope
- Stop-line-aware growth recommendation

**validation:** Hardware proof on Tang Nano 20K; audit PASS #8589.

### Hardening Lane — Sprite Pattern Memory Foundation

**Status:** DONE (`e86fe49`)
**depends_on:** [Sprite Envelope Hardening]
**scope_boundary:** Rebuild sprite pattern storage with BSRAM-backed Mem. No new sprite evaluation logic.
**delivers:**

- BSRAM-backed sprite pattern RAM with bus write port
- Backward-compatible default pattern content

**validation:** Hardware proof; audit PASS #8605.

### Hardening Lane — Sprite Phase 2 + 2-bis

**Status:** DONE (`39a7242`)
**depends_on:** [Pattern Memory Foundation]
**scope_boundary:** Per-sprite bppSel, priority levels, palette bank plumbing. No new sprite count expansion.
**delivers:**

- Per-sprite bppSel (4bpp/2bpp/1bpp)
- 4-level priority in compositor
- Palette bank wired through to compositor

**validation:** Hardware proof Scenario 50 (`39a7242`); audit PASS #8638.

### Hardening Lane — Color/Window Hardening

**Status:** DONE (`0f5dc65`)
**depends_on:** [Pattern Memory Foundation, Phase 2]
**scope_boundary:** Runtime palette RAM, dual window + combinations, per-layer masking, color math enhancement. No inter-palette blending, no post-compositor effects beyond ColorMath.
**delivers:**

- Runtime-writable palette RAM (CW-1 ✅)
- Sprite palette bank consumer in compositor (CW-2 ✅ — wired during Sprite Phase 2 P2-3a)
- `mathEnable` metadata → ColorMath gate (CW-3 ✅)
- Highlight mode in ColorMath (CW-4 ✅)
- Second window comparator + combination logic (CW-5 ✅)
- Per-layer window masking (CW-6 ✅)

**validation:** Sim proofs + hardware proof (Scenario 51 + 52 captured); resource report confirming green zone; audit PASS #8654.

### Hardening Lane — Beam-Driven Automation Hardening

**Status:** DONE (`6345fcc`)
**depends_on:** [Color/Window Hardening]
**scope_boundary:** Sub-scanline precision, control-flow instructions, full-frame HDMA, independent triggers. No full CPU software renderer.
**delivers:**

- Pixel-precise Copper WAIT (X,Y) (BH-1 ✅)
- Copper conditional SKIP instruction (BH-2 ✅)
- HDMA 9-bit line compare (BH-3 ✅)
- HDMA Indirect mode (BH-4 ✅)
- 4× independent raster triggers (BH-5 ✅)
- Linestate robustness (write-commit collision) (BH-6 ✅)

**validation:** `CopperSim`, `CopperHdmaSim`, `RasterTrigger4xSim`, `LinestateRobustnessSim` ALL PASS; HW smoke test Scenario 60 (`6345fcc`); audit PASS #8662.

For the current roadmap, the remaining broad substrate closure order is:

1. **Task 45** — Sprite Capacity Hardening
2. **Task 46** — V-Scroll Table Primitive
3. **Task 47** — DMA-Style Transfer Primitive
4. **Task 48** — Four-Layer Compositor Expansion
5. **Task 49** — Blitter-Class Block Transfer Engine

Task **40** is deferred until these broad primitives are in place and the team
is ready to prove a specific platform adapter on top of the shared substrate.

### Task 44 — Raw Bitmap + Attribute Fetch Primitive

**Status:** DONE (`a87bcd3`) — decoder primitive + register block + L0 mux. SDRAM row-buffer deferred to Task 44b.
**depends_on:** [17, 32a]
**scope_boundary:** Raw bitmap + attribute fetch only. No platform-exact register maps, no blitter, no full adapter semantics.
**delivers:**

- Linear bitmap fetch path suitable for bitmap-first adapters
- Attribute overlay / color-source path for bitmap+attribute display models
- Register-bus controlled base addresses and mode controls
- Stable SDRAM layout contract for bitmap rows and attribute rows

**validation:**

- Sim: bitmap + attribute scenes prove row fetch, attribute application, and palette selection
- Hardware: visible bitmap+attribute proof on Tang Nano 20K with 30s OpenCV stability analysis

### Task 44b — Bitmap SDRAM Fetch + Upload Path

**Status:** DONE (`8c03feb`; evidence #8179; audit PASS #8183)
**depends_on:** [44]
**scope_boundary:** SDRAM-backed bitmap row fetch + data upload/init only. No decoder changes, no register map changes, no platform adapter semantics.
**delivers:**

- `BitmapRowFetch` SDRAM-domain module for linear bitmap + attribute row reads
- Scheduler client-1 slot activation + arbiter wiring
- Live `bitmapByte` / `attrByte` delivery to existing `BitmapFetch` decoder
- Bootstrap/init path for bitmap+attribute data into SDRAM
- Sim proof and hardware proof of the SDRAM-backed fetch pipeline

**validation:**

- Sim: `BitmapRowFetchSim` proves correct SDRAM addressing and byte delivery per pixel
- Hardware: direct Sc45 capture evidence #8179 showed Sc45 lock, active canaries, and forced overlay; CyanPeak #8183 accepted black bitmap region as post-outage SDRAM state and passed CP-B closure

### Task 45 — Sprite Capacity Hardening

**Status:** DONE (`9aba5fb`; evidence #8190; audit PASS #8191)
**depends_on:** [28, 29]
**scope_boundary:** Sprite storage and evaluator scale only. No platform-exact OAM maps, no new compositor layers.
**delivers:**

- Synthesis-stable descriptor storage for larger sprite sets (BRAM / `Mem` if needed)
- At least `descCount=32`
- At least `visiblePerLine=8`
- Host-visible status semantics preserved under the larger sprite load

**validation:**

- Sim: mixed scenes with >32 descriptors and >8 visible candidates prove stable selection and limit behavior
- Hardware: visible multi-sprite proof on Tang Nano 20K with expected per-line cull behavior

### Task 46 — V-Scroll Table Primitive

**Status:** DONE (`90065fc`; evidence #8202; audit PASS #8204)
**depends_on:** [31, 32a]
**scope_boundary:** V-scroll lookup state only. No new fetch formats, no additional compositor math.
**delivers:**

- Per-column or per-band V-scroll table primitive parallel to Task 31 H-scroll support
- Register-bus address block for host / Copper writes
- Integration point before the existing vertical wrap / address path

**validation:**

- Sim: mixed vertical-offset scene proves per-band/per-column Y displacement
- Hardware: visible V-scroll table effect on Tang Nano 20K

### Task 47 — DMA-Style Transfer Primitive

**Status:** DONE — implementation `706ede2`; proof packet #8212; CyanPeak audit PASS #8214
**depends_on:** [30, 32b, 39]
**scope_boundary:** Block-transfer primitive only. No blitter raster ops, no platform-specific DMA command sets.
**delivers:**

- Register-bus triggered local transfer engine for repeated asset / descriptor movement
- Bounded copy/fill semantics suitable for OAM/VRAM-style workloads
- Status / completion signaling compatible with the existing host-control surface

**validation:**

- Sim: bounded copy/fill transactions land correctly under active fetch load
- Hardware: Pico-triggered DMA-style transfer visibly updates rendered state without corruption

### Task 48 — Four-Layer Compositor Expansion

**Status:** DONE — implementation PASS #8227 at commit `fd1c07d`
**depends_on:** [41]
**scope_boundary:** Layer-count expansion only. No platform-specific mode tables, no new color-math semantics beyond existing contracts.
**delivers:**

- 3rd and 4th background/compositor input paths
- Priority contract extended across all active layers
- Metadata propagation preserved across the wider compositor

**validation:**

- Sim: 4-layer composition scenes prove deterministic priority and metadata handling
- Hardware: visible 3+/4-layer proof on Tang Nano 20K

### Task 49 — Blitter-Class Block Transfer Engine

**Status:** DONE — implementation PASS #8248 at commit `9c5f08d`
**depends_on:** [47, 41]
**scope_boundary:** Block-transfer engine only. No full platform adapter, no CPU-side software renderer.
**delivers:**

- Rectangular copy/fill primitive over local video memory
- Register-bus control/status surface for scheduled blit operations
- Bounded overlap / in-progress / completion semantics

**validation:**

- Sim: copy/fill operations complete correctly under concurrent fetch load
- Hardware: visible block-transfer proof on Tang Nano 20K

---

## Phase 10 — Platform Adapters

### Task 50 — ZX Spectrum Adapter (Bitmap + Attribute)

**Status:** DONE (v2 #8681; v3.8 #8968 — bitmap active region debug complete, flicker eliminated)
**depends_on:** [40, 44, CW-1, CW-5]
**scope_boundary:** Thin translation layer only. No cycle-accurate ULA. No 128K paging. No contention modeling. No AY audio. Pre-shuffled bitmap upload (host-side responsibility).
**delivers:**

- `ZXSpectrumAdapter` component translating ULA-style registers to Mode0 bus writes
- Border implementation using existing dual-window logic
- 15-color Spectrum palette loaded into runtime palette RAM
- Hardware proof: recognizable 256×192 Spectrum display centered in HDMI frame

**validation:**

- Sim: `ZXSpectrumAdapterSim` produces correct bus writes for border/control changes
- `VdpTopSim` regression passes with adapter present (disabled path)
- Hardware: Scenario 50 static frame with visible bitmap + attributes + border, 30s capture stable

**v3.4 lane notes (latest first):**

- #9010: **CyanPeak audit — Host-Init Phase 2 PASS; lane CLOSED.** Signature upload proof audited: host-uploaded `0xAA`/`0x55` stripes at HDMI lines 40–55 are coherent (std 42.5) vs uninitialized neighbors (std 79.2). `skipSdramInit` FSM bypass clean. Recommends ledger sync and Phase 3 deferred.
- #9009: **BrightForge — E3.47 hardware proof. Host-Init Phase 2 PROVEN.** `skipSdramInit` param added to `BitmapRowFetch.scala`; `vdp_sdram_write()` opcode `0x02` added to ESP8266 sketch. Signature rows 20–27 show vertical `0xAA`/`0x55` stripes. Phase 1 toggle continuity preserved (2.000s square wave). Build clean, no timing violations.
- #9008: **BronzeGate — E3.47 authorized.** BrightForge to start implementation using audited Option B proof shape from #9005/#9006. No further planning round needed.
- #9006: **CyanPeak audit — CoralReef #9005 preflight artifact PASS.** Option B (signature upload) approved as bounded Phase 2 proof. Full 240-row upload deferred to follow-up. BrightForge authorized to code.
- #9005: **CoralReef — Host-Init Phase 2 preflight artifact.** Exact scope boundary, affected seams, SDRAM init facts, three proof options, risks, activation recommendation. Option B (signature upload, ~130ms) recommended.
- #8995: **CyanPeak audit — proof boundary explicit.** Host-side execution PROVEN (ESP8266 serial log). FPGA video PROVEN (RTSP live/non-black). End-to-end host control NOT proven — fallback state ambiguity. Next discriminator: live visible toggle.
- #8993: **BronzeGate direct bench handoff — ESP8266 NodeMCU host-init ALIVE.** Full 220-word copper upload + 9 register writes execute to "init complete". RTSP capture non-black (mean 115.59/255). Cannot yet prove displayed scene is host-driven vs fallback.
- #8992: **BronzeGate — classic ESP32 reflashed cleanly.** Safe map (GPIO 18/19/22/23/25/27) compiles and boots. Host-init sketch runs end-to-end.
- #8990: **BronzeGate — bench guidance for classic ESP32.** Minimal sanity sequence (USB only → GND only → GND+CS_N → GND+SCK) to classify failure mode without thrash.
- #8989: **BronzeGate PM ruling — one last bounded sanity sequence, then partial Phase 1 closure if still unstable.** Prevent low-yield bench iteration.
- #8987: **BronzeGate — strap-safe pin remap for classic ESP32.** GPIO 18/19/22/23/25/27 (non-strap, non-flash, non-JTAG). Avoids Tang pull-up/down conflicts.
- #8985: **BrightForge — ESP32-C3 confirmed rev v0.3 deprecated silicon.** Flash-cache/MMmu bugs documented by Espressif. No software workaround. FPGA side remains complete.
- #8984: **BronzeGate PM ruling — Host-Init Phase 1 remains open; recovery = alternate host.** FPGA sub-slice complete. Do not spend more cycles on failed ESP32-C3.
- #8982: **BrightForge — E3.46 / Host-Init Phase 1 FPGA side COMPLETE; ESP32-C3 hardware BLOCKER.** `useHostInit` flag + bootstrap bypass implemented and gen-verified. ESP32-C3 cannot be reflashed (partition table reads 0xFFFF). Asks PM ruling on recovery path.
- #8981: **BronzeGate — conditional `useHostInit` flag acceptable for Phase 1 scope.** Keeps slice bounded to sc45; other scenarios unchanged.
- #8980: **BrightForge — Host-Init Phase 1 implementation strategy.** Conditional `useHostInit` param, sc45 bitstream with bootstrap bypassed, ESP32 sketch with 220 copper words + 9 register writes. 29 ms init time at ~500 kHz.
- #8979: **BronzeGate — Host-Init Phase 1 activated.** Remove bootstrap FSM, migrate register/copper init to host. Do not widen into SDRAM upload or ROM elimination.
- #8978: **CyanPeak — E3.45 audit PASS; Task 50 v3.8 CLOSED.** Metrics decisive. No further audit needed on bitmap lane.
- #8976: **BrightForge — E3.45 hardware proof. Bottom band ELIMINATED; analyzer FIRST PASS.** `bitmapYActive = bitmapEnable && (vCounter < 192)` at source mux. Metrics: glitch=0.00, freeze=0.00, motion=0.51. Bitmap region clean above vCounter=192, scenario content visible below. Build confirms exact placement per CoralReef #8973 spec.
- #8974: **BronzeGate — E3.45 ACTIVATED; host-init Phase 1 queued next.** PM ruling on converged preflight #8973/#8975.
- #8975: **CyanPeak — converged preflight recommendation.** E3.45 ACTIVATE NOW, host-init Phase 1 next, Phases 2–3 deferred.
- #8973: **CoralReef — independent preflight + convergence.** Source-mux y-gate method, three-phase host-init breakdown, convergence table with CyanPeak.
- #8968: **BronzeGate — Task 50 v3.8 formally CLOSED.** E3.44 full ping-pong double-buffering eliminated flicker (glitch 1.57% → 0.23%, motion 3.25% → 0.07%). Sim regression 0 hangs / 48 lines.
- #8967: **CoralReef independent analysis — fillSelect logic and swap boundary verified correct.** H_ATTR_DISPLAY_RACE confirmed: attr bytes 0..5 late due to fetch timing. Bottom band ruled pre-existing scope artifact (bitmap active for 480 lines but only 240 rows initialized). Converged on double-buffering as fix.
- #8966: **CyanPeak audit — flicker class CLOSED.** Proof packet accepted: commit tie-back, metrics, sim regression, hardware captures. No further audit required.
- #8963: **CoralReef paired diagnosis — structural race root cause identified.** Attr bytes 0..5 fetched AFTER display reads them. Each retry delays attr start by +64 cycles, widening stale-color region. Statistical retry variation causes flicker. Bitmap bytes always safe; race is in attr phase.
- #8960: **CyanPeak audit — E3.43 retry/timeout fix CLOSED.** Blocker lifted. Bitmap region renders test pattern. RED LIT = retry fired. Hardware proof accepted.
- #8895: **BrightForge reverted E3.29 to BSRAM baseline.** BitmapRowFetch lineBufs restored to `Mem(Bits(8 bits), 128)`, `byteIdx < 80` restored. PNR clean: Logic 74%, Reg 52%, BSRAM 17. RTSP md5 = `ea5017b1...` (byte-identical to E3.28). BrightForge standing by for team direction on next mechanism.
- #8894: **BrightForge E3.29 — Vec(Reg) row-buffer fix REGRESSED to all-black.** `bitmapLineBuf`/`attrLineBuf` converted to `Vec(Reg(8 bits), 64)` (128-deep overflowed CLS at 1,239 unplaced REGs). `byteIdx < 80` changed to `< 64`. PNR clean: Logic 75%, Reg 58%, BSRAM 15. Hardware: screen nearly all black, RED dimmed (190 vs 243), GREEN DARK (0 vs 193), ORANGE still LIT (158). Bitmap mean dropped from 6.79 to 0.71. Likely timing degradation from Vec(Reg) mux congestion, not functional error. Reverted in #8895.
- #8893: **BronzeGate archived gotcha research.** Relevant to current lane: GOTCHA-017 (combinational module-boundary timing hazard), GOTCHA-021 (`syn_preserve` blocks BSRAM output inference). Reference-only, not lane authority.
- #8892: **BrightForge E3.28 result — squash isolated INSIDE BitmapRowFetch BSRAM round-trip.** PURPLE (`bitmapByteHotInDisplay`) DARK, YELLOW (`attrByteHotInDisplay`) DARK in display window [40,192). Combined with E3.27 (fetchGrant LIT, sdramByte LIT for fillLine≥40): data reaches BitmapRowFetch input but `bitmapLineBuf.readAsync()` / `attrLineBuf.readAsync()` return zero for bitmap rows. Same Gowin SDPB defect class as LinestateStore.
- #8881: **CoralReef deep audit — v4 Vec(Reg) Verilog structurally correct, but drainIdx STILL DARK.** Generated Verilog confirms 256 explicit 4-bit registers, one-hot write decoder, case-statement read mux, `RegNext` read pipeline. Synthesis: 1,028 registers in lineBuf module, BSRAM 15/46. PNR: 0 unplaced REGs, 96% CLS. Hardware: RTSP capture byte-identical to E3.23. RED (`fillIdx`) LIT, GREEN (`drainIdx`) max=23 DARK. Proposed discriminator: STICKY `drainIdx != 0` probe + display-window-only `pixelIndex` count probe to distinguish sparse-data (H2) from true line-buffer failure (H3/H4).
- #8878: **BrightForge v4 hardware test — Vec(Reg) 256×4 single-buffer PNR PASS, load OK, but drainIdx DARK.** CLS 96%, 0 unplaced REGs, 15 BSRAMs. Timing 22.489 MHz vs 25.200 target (1,033 setup violations). Bitstream loaded successfully. Canary result identical to E3.23: RED LIT, GREEN DARK, all downstream sticky catches DARK. Vec(Reg) fix did NOT move drainIdx.
- #8875: **CoralReef synthesis audit — 4-bit split-width synthesis complete, PNR pending.** 7-bit single-buffer attempt FAILED PNR with 2,004 REGs unplaced (97% CLS). BrightForge dropped to 4-bit (`drainIdx` only) single-buffer Vec(Reg) + BSRAM metadata ping-pong. Synthesis reports 10,756 registers (down from 12,679), 13,253 LUTs. CLS estimate ~86% — may fit. PNR must be rerun.
- #8874: **CoralReef CLS blocker — split-width Vec(Reg) EXCEEDS CLS budget.** Full 7-bit double-buffer = 8,960 FFs needs ~4,480 CLS, but only 614 CLS available. Proposed `keep` attribute experiment as zero-cost alternative before committing to impossible fix.
- #8873: **CyanPeak audit ruling — E3.24 split-width LineBuffer AUTHORIZED.** Authorized moving palette-critical 7 bits (`drainBank` + `drainIdx`) to Vec(Reg) with 1-cycle read latency. Estimated ~4,480 FFs, ~63% Reg total. Keep metadata in BSRAM or drop. Recommends full 640-entry array for timing simplicity.
- #8872: **BronzeGate directive — E3.24 split-width LineBuffer fix AUTHORIZED.** Per #8871 smoking gun. Approach mirrors proven LinestateStore v4 pattern. Guardrails: do not reopen upstream theories unless fix fails to move `drainIdx`; do not broaden to full-line Vec(Reg) unless split-width proven insufficient.
- #8871: **E3.23 SMOKING GUN — `fillIdx` LIT, `drainIdx` DARK.** Count-threshold probes (strict stage rule): `fillIdx` ALIVE (>256/frame), `drainIdx` DEAD (≤256/frame). All downstream sticky catches (`priorityMuxSquashEver`, `spriteLoopSquashEver`) DARK. Downstream path fully exonerated: `layerMaskActive=False`, `combinedWindowEffect=False`, ColorMath=passthrough. Squash boundary definitively isolated at LineBuffer BSRAM round-trip. Same Gowin SDPB defect class as LinestateStore (E3.14 v4).
- #8866: **CoralReef downstream path audit — post-fillIdx control path exonerated.** `layerMaskReg=0x00`, `winCombReg=0x00`, `colorMathReg=0x00`, border=outside-only. No control-path squash possible for sc45.
- #8844: **BrightForge sc50 cross-check — palette FULLY EXONERATED.** sc50 vibrant red border = palette[24] works. Black bitmap = squash is strictly in bitmap pipeline, not palette.
- #8841: **CyanPeak audit ruling — E3.16b upstream data hunt AUTHORIZED; palette fix DEFERRED.** Palette working (sc8 proof + sc50 proof). Re-focus on bitmap path: SDRAM read, FIFO drain, pixelIndex decode, line buffer write. Authorized probe chain: `sdramByte` → `bitmapByte` → `attrByte` → `pixelIndex` → `fillIdx` → `drainIdx`.
- #8831: **CoralReef paired finding — sc8 proves palette works; probes miswired; upstream bitmap path suspect.** BrightForge #8830: sc8 renders correctly with v2 code, proving palette FSM init + `readAsync` work. CoralReef code review found: (a) `dbgBitmapByteNonZeroThisFrameR` checks `effectiveL0Enable` NOT `bitmapByte != 0`, (b) `dbgFillIdxNonZeroEverR` checks `linestate.io.layer0Enable` NOT `fillIdx != 0`. We have NO evidence data flows from BitmapFetch → lineBuf → drainWord in sc45. Palette is likely correct; issue is upstream in bitmap fetch/SDRAM/FIFO path. Recommended: proper probes for `bitmapByte != 0`, `fillIdx != 0`, `drainIdx != 0`.
- #8830: **BrightForge paired evidence — sc8 RENDERS CORRECTLY; palette diagnosis falsified.** sc8 (tile scenario) renders vibrant colors with v2 code. Proves: palette `readAsync` works, FSM init walk works, BSRAM not fundamentally broken. Squash is sc45-specific. Suspects: `primedR` gating, LayerCompositor squash, or drainIdx=0 from attribute decode. Requests paired trace with CoralReef.
- #8827: **BronzeGate workflow change — BrightForge+CoralReef paired primary bug-fix team.** Directive: converge on shared diagnosis before presenting lane-truth update. Expectation: agreed packet with evidence, rejected theories, exact fix/next discriminator, authority status. CyanPeak remains audit owner for agreed result.
- #8826: **E3.16 v1/v2 BOTH FAILED.** v1: 128-entry Vec(Reg) overflowed CLS (1731 REGs unplaced, 76% Logic, 94% CLS). v2: Mem+FSM init walk (0..127 writes at boot) also shows `paletteRgb` DARK. BrightForge interprets this as Gowin BSRAM `readAsync` fundamentally broken even for runtime writes. Proposes Options D/E/F; recommends E (Vec(Reg,32)). CoralReef pending paired review.
- #8824: **CyanPeak TASKS.md sync — #8822 integrated, Hold LIFTED.** Updated ledger: Latest Auth Mail → #8822, Next Deliverable → E3.16 128-entry palette Vec(Reg), coding authorized.
- #8822: **CyanPeak audit ruling — 128-entry palette Vec(Reg) AUTHORIZED; Hold LIFTED.** Re-audited #8820 finding. Confirmed: 16-entry aliases sc50 bright (16..23) and L1 bank=4 (64..79). 128 entries is the minimum safe scope preserving all existing Mode0 bank scenarios. Register cost 3072 FFs (~66% util) within safe margin. BrightForge cleared to implement.
- #8821: **BronzeGate directive — E3.16 HELD pending palette-size re-audit.** CyanPeak to re-audit #8820 and issue ruling on minimum safe palette Vec(Reg) size (128, 32, or 16 entries). BrightForge coding paused. CoralReef to sync ledger once ruling lands.
- #8820: **CoralReef deep audit — BrightForge reasoning CONFIRMED sound, but 16-entry palette Vec(Reg) is NOT SAFE.** Independent code review confirms: (a) sc45 bright=0 → only palette entries 0..7 accessed (safe with 16), (b) sc50 bright=1 → entries 16..23 accessed (OUT OF BOUNDS for 16-entry Vec), (c) L1 tile layer attribute map uses bank=4 (entries 64..79) per `TileAttributeAssets.attributeMapBytesInit` — 16 entries would SILENTLY ALIAS to wrong colors. SpinalHDL `Vec(N)(addr)` with `addr >= N` uses lower bits only, causing color corruption not crashes. Recommended: 128 entries (3072 FFs, ~66% reg util vs current 52%) preserving all scenarios, or 32 entries with sc50 bright-remap and L1 bank-restriction. Full audit report in #8820 mail.
- #8819: **CyanPeak TASKS.md sync — #8818 integrated.** Updated ledger: Latest Auth Mail → #8818, Next Deliverable → E3.16 palette Vec(Reg) fix.
- #8818: **CyanPeak audit ruling — E3.16 authorized (palette → Vec(Reg)), deep audit PASS.** Authorized 16-entry Vec(Reg) tight variant. Assessment: BrightForge reasoning sound, probe methodology excellent, capture discipline correct, next-step optimal. Caveat: 16-entry size not independently verified for L1/sc50 bank coverage in this ruling.
- #8817: **BronzeGate deep audit request to CoralReef.** Scope: review BrightForge work quality, probe chain correctness, capture discipline, next-step quality on Task 50. Requested independent verification of conclusions.
- #8816: **E3.15 result — SQUASH AT PALETTE.** BLUE (`bitmapFetch.io.pixelIndex != 0`) LIT, GREEN (`paletteRgb != 0`) DARK, RED (`io.red != 0`) DARK. Pipeline chain: `layer0Enable`→`fetchGrant`→`effectiveL0Enable`→`pixelIndex`→`drainWord` all LIT; `paletteRgb` first DARK. Diagnosis: Gowin BSRAM `readAsync` + `initialContent` defect affects palette Mem identically to LinestateStore. Proposed fix: replace palette Mem with Vec(Reg). Recommended 16 entries; CyanPeak authorized.
- #8815: **CyanPeak TASKS.md sync — #8814 integrated.** Updated ledger for E3.15 authorization.
- #8814: **CyanPeak audit ruling — E3.15 authorized.** Terminal-stage squash hunt: probe `io.red`, `paletteRgb`, `pixelIndex`. Capture via webcam fallback.
- #8800: **E3.14 v1 NEGATIVE — 96-line copper WSEQ partial coverage did not light sc45.** BrightForge implemented 12 WRITE_SEQ groups covering lines [40,136). `layer0Enable` and `effectiveL0Enable` probes both DARK. Two interpretations: (a) copper writes never reach `prepare`, or (b) writes reach `prepare` but `commit` doesn't update in time. Proposes v2 with full 192-line coverage or `linestate.writeEnable` counter probe.
- #8812: **E3.14 v4 result — SPLIT-WIDTH FIX WORKED, but bitmap still dark.** RED (`layer0Enable`) LIT for first time in entire investigation. BLUE (`fetchGrant`) LIT. YELLOW/ORANGE likely LIT. All internal pipeline probes now report non-zero per-frame. Yet bitmap region on webcam remains black/dim. Terminal-stage squash suspected: ColorMath, LayerCompositor, or palette index 0. E3.15 proposed: non-sticky `io.rgb`, `paletteRgb`, `pixelIndex` probes.
- #8811: **RTSP capture path FROZEN.** `rtsp://192.168.1.95:8554/live` returns byte-identical frames across v2/v3/v4 builds (same MD5 over 1h40m). Webcam stream `rtsp://192.168.1.244:8554/unicast` confirmed working as alternative proof path. FPGA output IS changing (webcam shows distinct frames); Guermok RTSP path is stuck.
- #8808: **CyanPeak audit ruling — E3.14 v4 authorized.** Option C1 split-width fix: move 2-bit layer enables (`layer0Enable`, `layer1Enable`) into `Vec(Reg(Bits(2 bits)), lineCount=480)` (~960 FFs). Keep 10-bit `scrollX` in existing BSRAM Mem. Sidesteps Gowin BSRAM SDPB `readAsync` defect on critical enable path. ScrollX defaulting to 0 is acceptable for sc45/sc50.
- #8807: **E3.14 v3 hits two walls.** Wall 1: full-width `Vec(Reg(Bits(12 bits)), 480)` overflows GW2AR-18 (PNR ERROR: 4792 REGs unplaced, 82% FF, 94% CLS). Wall 2: even eliminating `commit` entirely and reading `prepare.readAsync` directly produces identical black behavior — the SDPB `readAsync` defect affects BOTH Mems. Proposes three budget-aware options: C1 (split width), C2 (Mem read pipeline), C3 (global enable bypass). Recommends C1.
- #8805: **CyanPeak audit ruling — E3.14 v3 authorized.** Structural fix: replace `commit` Mem with `Vec(Reg(Bits(12 bits)), lineCount=480)` (~5760 FFs). Keep `prepare` as BSRAM. Remove probes once sc45 renders. *Superseded by #8807: full-width Vec(Reg) overflows device.*
- #8804: **E3.14 v2 result — GREEN LIT, RED DARK.** `dbgLinestateWrSeen` (GREEN) LIT proves copper writes reach `LinestateStore` boundary. Yet `linestate.io.layer0Enable` (RED) DARK — commit-side `readAsync` returns False despite writes arriving. Diagnosis: Gowin BSRAM SDPB `readAsync` silently mapped to registered read with extra latency, breaking same-cycle write-then-read.
- #8802: **CyanPeak audit ruling — E3.14 v2 authorized.** Identified FIFO bottleneck (only 1 copper write drains per scanline). Authorized full 192-line coverage + burst-drain window (`hCounter < 256`) + `dbgLinestateWrSeen` liveness probe.
- #8799: **CyanPeak audit ruling — copper workaround authorized (E3.14).** LUTRAM fix definitively failed. Authorized bumping copperFifo depth to 128 and adding 192 WRITE_SEQ writes (`0x0000..0x01BF = 0x0800`) at y=0 to populate linestate dynamically. Success criteria: sc45 bitmap visible + `layer0Enable` LIT.
- #8797: **LUTRAM fix attempt FAILED.** BrightForge added `ram_style = "distributed"` and `syn_ramstyle = "distributed"` to `LinestateStore.commit`/`prepare` Mems. Verilog shows attributes present, but Gowin synth ignored both. sc45 still black, `layer0Enable` still DARK. Copper-driven linestate population proposed as workaround. Awaiting audit re-authorization.
- **CoralReef synthesis-log audit:** Gowin `gwsynthesis/project.log` shows `WARN (EX0200) : Property "syn_ramstyle" set invalid for "prepare"` (line 109). Both `prepare` and `commit` were "Extracting RAM" but no LUTRAM confirmation. PNR report shows 18 BSRAMs (16 SDPB + 2 SDPX9B). Correlation with unchanged hardware behavior confirms BSRAM inference despite attributes.
- #8796: **CyanPeak audit ruling — SMOKING GUN FOUND, fix authorized.** Root cause: Gowin BSRAM `initialContent` failure in `LinestateStore`. `linestate.io.layer0Enable` reads False for all visible rows. Authorized LUTRAM force on `commit`/`prepare` Mems. *Superseded by #8797: LUTRAM attributes ignored by Gowin.*
- #8795: **E3.13 SMOKING GUN.** Per-frame probes with strict border exclusion: `linestate.io.layer0Enable` DARK, `effectiveL0Enable` DARK. `layer0Enable` is False for every visible line. Root cause: `LinestateStore` BSRAM init fails silently; `defaultInit(l0en=true)` not honored on silicon. Tile scenarios work because they dynamically write linestate; sc45 does not.
- #8794: **CyanPeak audit ruling** — E3.11/E3.12 paradox resolved. Sprite-squash ruled out; gate-asymmetry identified. E3.13 authorized to probe `linestate.io.layer0Enable` and `effectiveL0Enable`.
- #8793: **E3.11/E3.12 result — sprite-squash ruled out, paradox resolved.** E3.11: `composedBgIdx` LIT, `spriteWins` DARK, `fillIdx` LIT — no sprite override. E3.12: matched gates (`fillLine ∈ [40,192)`) show `fillIdx` genuinely DARK for visible rows. Contradiction resolved: earlier `fillIdx` LIT was from fill cycles outside visible range. Suspect shifts to `linestate.io.layer0Enable`.
- #8791: **CyanPeak audit ruling** — E3.10 paradox localized. `fillIdx` LIT per-frame (non-zero into line buffer) but `drainWord` DARK per-frame (zero out). Upstream stall theory debunked. Two suspects: (a) sprite path silently squashing `fillIdx`, or (b) line buffer addressing/bank mismatch. E3.11 authorized to probe `composedBgIdx`, `spriteWins`, `fillIdx`.
- #8789: **E3.10 result — paradox at line buffer boundary.** Per-frame probes: `bitmapByte` LIT, `attrByte` LIT, `fillIdx` LIT (RED), but `drainWord` DARK (YELLOW). Data reaches line buffer input every frame but reads zero during display. Tile scenarios use same line buffer and work. Contradiction suggests sprite-override or addressing asymmetry specific to sc45.
- #8786: **CyanPeak audit ruling** — E3.6c upstream failure localized. BitmapRowFetch's per-line fetch loop is stalled post-init; line buffers never refresh. E3.7 authorized to probe `fetchGrant` and per-frame `bitmapByte`. *Superseded by E3.10: upstream stall theory debunked; data DOES reach line buffer input.*
- #8784: **E3.6c result — per-frame-reset probes reveal ALL DARK.** `drainWord`, `mathRgb`, `io.rgb` all zero every frame. Earlier sticky "LIT" results (E3.5, E3.6a) were startup transients from synth-init phase. Bug is much further upstream: BitmapRowFetch per-line fetch never re-pulses after init. Line buffer, palette, display mux all structurally sound.
- #8780: **E3.6a result — `mathRgb` LIT, `io.{r,g,b}` LIT, yet capture still black.** Sticky probes say non-zero RGB reaches `video.io` in the sc45 bitmap region, but pixel inspection shows only canary bottom-edge bleed. Contradiction later resolved by E3.6c: sticky probes latched startup transient. E3.6b proposed but superseded by E3.6c.
- #8768: **E3.5 result — ALL 6 probes LIT** with correct sc45 region gating. BLUE (fillIdx), YELLOW (drainWord), ORANGE (paletteRgb) all non-zero in bitmap region. **Visible bitmap region still black.** Bug definitively downstream of `paletteRgb`, upstream of `video.io.r/g/b`. Suspects: `layerMaskActive`, ColorMath squash, `borderActiveR`, `deR && primedR` gating. E3.6 proposed to probe `mathRgb` and `displayRgb`.
- #8766: **ESP32-C3 smoke-port implementation landed** — `firmware/esp32c3_qspi_smoke/esp32c3_qspi_smoke.ino`. Bit-banged QSPI at ~500 kHz, direct GPIO registers, 8-byte REG_WRITE frame matches Pico protocol. Compiles clean: 277,802 bytes (21%). Ready for flash once wired.
- #8762: BrightForge building E3.5 with probes re-gated to sc45 natural region `[0,256)×[0,192)`. Toolchain note: ESP-IDF not installed; Arduino-cli + esp32:esp32 core v3.3.7 available for ESP32-C3 sidecar lane.
- #8760: CyanPeak audit — approved E3.5 re-gating. Retracted #8756 GoldReef identity / bank-swap theory. Confirmed `(hCounter+1)` pre-advance properly compensates `readSync` latency; line buffer timing is structurally sound.
- #8758: E3.4 result + **probe gating mistake discovered**. YELLOW (`dbgDrainWordNonZeroEver`) **LIT** when UNGATED. Line buffer write→read round-trip is structurally sound on hardware. Earlier "DARK" verdicts (E3.3b, E3.3) were checking sc50 border region `[192,448)×[144,336)` while sc45 renders at `[0,256)×[0,192)` — mostly empty overscan. **Supersedes #8753 line-buffer-failure theory.**
- #8753: E3.3b result — BLUE (`dbgFillIdxNonZeroEver`) **LIT**, YELLOW (`dbgDrainWordNonZeroBmRegionEver`) **DARK** (gated to sc50 border region). `fillIdx` is non-zero entering line buffer. *Interpretation superseded by #8758: gating region mismatch, not line-buffer failure.*
- #8746: LUTRAM force result — `palette.addAttribute("ram_style", "distributed")` did **NOT** fix bitmap region. ORANGE still DARK. BSRAM-inference theory ruled out.
- #8745: E3.2 result — BLUE (`dbgBitmapFetchPixelNonZeroEver`) LIT, ORANGE (`dbgVideoRgbNonZeroBmRegionEver`) DARK. Bug localized to between `bitmapFetch.io.pixelIndex` and `video.io.rgb`. Palette read path is the surviving suspect. Matches CyanPeak #8723 BSRAM-inference theory (later disproven by #8746).
- #8743: E3.1 result — ALL 6 probes lit including attrNonZeroR and pixelNonZeroR. Bitmap region STILL truly zero. Bug narrowed to between BitmapFetch internal decode and final HDMI RGB.
- #8740: Capture-path hardening plan — frame-border canary + E3.1 probe restoration + Tier-2 docs/scripts (check_transport.py, CAPTURE.md). DONE.
- #8739: Refined E3 result — ALL 5 upstream gates lit on sc45 HW. But 256×192 active region is genuinely zero. Bug narrowed to: (a) attr reads zero, or (b) BitmapFetch decode collapses, or (c) palette/compositor downstream.
- #8738: Transport canary landed — bottom-right 16×16 cyan block + 1-pixel frame border. Verified on sc50 HW. Confirms earlier black captures were HDMI receiver lock failures, not FPGA scene failures.
- #8726: E1 sim PASS — BitmapRowFetch init logic proven correct with SDRAM memory model (4,096 bitmap + 8,192 attr writes correct). Init logic is sim-correct; bug is HW-specific.
- #8724: Historical capture analysis — sc45 was NEVER visibly working on hardware before v3. The Task 44b audit accepted black bitmap on canary evidence alone. Invalidates "v3 substrate regression" hypothesis.
- #8718: CyanPeak authorized v3.4 A/B regression (sc45 vs sc50).

**Task doc:** `PROJECT_PLAN/archive/tasks/TASK_50_ZX_SPECTRUM_ADAPTER.md`

---

### Task 51 — MODE_SELECT Runtime Adapter Selection

**Status:** DONE — Packet A audit PASS #9180; Packet B audit PASS #9192; Packet C audit PASS #9201
**depends_on:** [32b, 40, 50 v3]
**scope_boundary:** Infrastructure only. No new platform adapter behavior. No new substrate primitives. No changes to QSPI packet format (reuse REG_WRITE). No adapter-specific register semantics beyond gating.
**delivers:**

- `MODE_SELECT` register at `0x0313` with safe-boundary commit in `VdpTop`
- `AdapterRegRouter` component: intercepts QSPI writes to adapter address ranges and routes to active adapter
- `AdapterBusMux` component: muxes gated adapter bus outputs into `RegBusArbiter` master 2
- Output gating on `C64Adapter` and `ZXSpectrumAdapter` so inactive adapters are quiescent
- Always-instantiated adapters in `TopTang20kHdmi` (replace scenario-conditional with mode-conditional)
- `ModeSelectSim` unit proof (5 cases: switch, quiescence, router decode, safe-boundary timing)
- Updated `MODE0_REGISTER_BUS_SPEC.md` with `0x0313` and adapter address blocks

**validation:**

- Sim: `ModeSelectSim` 5/5 PASS
- `VdpTopSim` regression PASS with `MODE_SELECT=0x0` (native mode)
- `C64AdapterSim` + `ZXSpectrumAdapterSim` regression PASS with `modeSelect` active
- Hardware: single bitstream containing C64 + ZX adapters; host switches mode via QSPI, both scenes render correctly

**Task doc:** `PROJECT_PLAN/MODE_SELECT_ARCHITECTURE.md`

---

### Task 52 — Per-Sprite X/Y Flip Primitive

**Status:** DONE — CyanPeak audit PASS #9127
**depends_on:** [28, 29, 37]
**scope_boundary:** Bit-mirror primitive only. No whole-sprite size-aware mirroring for sizeSel > 16 (deferred to Task 53). No tile flip. No new register ranges or bus protocol changes. Dedicated firmware sketch per #9101 hygiene rule.
**delivers:**

- 2bpp/1bpp horizontal-flip bug fix in `VdpTop.scala` (lines 1335–1349)
- `SpriteFlipSim` unit test: 4bpp/2bpp/1bpp × 4 flip states = 12 sub-cases, all asserting pixel-perfect mirror
- `sc62_sprite_flip` hardware scenario block in `TopTang20kHdmi.scala`
- Dedicated ESP32 sketch `firmware/esp32_sc62_sprite_flip/`
- RTSP capture + 30s OpenCV analysis proving 4-quadrant mirror grid

**validation:**

- Sim: `SpriteFlipSim` all cases PASS (4bpp, 2bpp, 1bpp each with no-flip / flipH / flipV / both)
- Existing sim regression: `SpriteEvaluatorSim`, `AffineSpriteSim`, etc. all still PASS
- Hardware: bitstream clean, no timing violations
- RTSP capture: pixel-perfect mirror symmetry verified by frame analyzer
- Cross-platform closure: NES, PCE, SNES, SMS/GG, Genesis, MSX2 flip gaps addressed

**Implementation progress (BrightForge #9123):**

| Stage | Status | Evidence |
|---|---|---|
| A — RTL fix | ✅ DONE | `VdpTop.scala` 2bpp/1bpp flip bug fix applied; `SpriteEvaluator.scala` docstring corrected |
| B — `SpriteFlipSim` | ✅ PASS | 12 evaluator combos + 1632 math checks across all bppSel modes |
| C — Regression sims | ✅ PASS | `SpriteEvaluatorSim`, `AffineSpriteSim`, `SpriteBusViaVdpTopSim` all PASS |
| D — Bitstream + sketch | ✅ DONE | TNS=0, 67% logic, Tang20k flashed. ESP8266 sketch compiled + flashed per #9122/#9123 |
| E — RTSP capture | ✅ PASS | 30s capture, 848 frames, 94.24% match, 0 flicker. Four-quadrant mirror grid verified |
| F — Audit | ✅ PASS | CyanPeak audit PASS #9126 (A/B/C) + #9127 (final) |

**Files changed (uncommitted, clean Task-52-only tree per #9113):**
- `hw/spinal/spinalhdlvdp/VdpTop.scala` (+13/−4, flip fix)
- `hw/spinal/spinalhdlvdp/SpriteEvaluator.scala` (+11/−3, docstring)
- `hw/spinal/spinalhdlvdp/TopTang20kHdmi.scala` (+50, sc62 copper program)
- `hw/spinal/spinalhdlvdp/SpriteFlipSim.scala` (new, 190 lines)
- `firmware/esp8266_sc62_sprite_flip/esp8266_sc62_sprite_flip.ino` (new, 175 lines, active proof firmware)
- `captures/sc62/sc62_30s.mp4` (new, 88 KB evidence)
- `captures/sc62/sc62_sample.png` (new, evidence)

**Task doc:** `PROJECT_PLAN/MODE0_PLANNING.md` §5 (Prioritized Backlog — Priority B: Sprite Envelope Hardening); see also `PROJECT_PLAN/ASSESSMENT.md` §2 (Sprite Envelope Assessment)

---

## Historical Task Artifacts

The following task artifacts contain detailed scope descriptions, design rationale, and proof records for closed lanes. They are **reference only** — `TASKS.md` remains the sole active task authority.

| Task | Artifact Path | Status |
|---|---|---|
| Task 2 — Sprite Capacity Expansion | `archive/tasks/TASK_2_SPRITE_CAPACITY_EXPANSION.md` | CLOSED (Tasks 2a/2c/2b) |
| Task 2a — Sprite Capacity Substrate Pre-Hardening | `archive/tasks/TASK_2A_SPRITE_CAPACITY_SUBSTRATE_PREHARDENING.md` | CLOSED |
| Task 2b — Sprite Capacity Bump | `archive/tasks/TASK_2B_SPRITE_CAPACITY_BUMP.md` | CLOSED |
| Task 2c — Sprite Evaluator Hardening | `archive/tasks/TASK_2C_SPRITE_EVALUATOR_HARDENING.md` | CLOSED |
| Task 3 — Planar Fetch Hardening | `archive/tasks/TASK_3_PLANAR_FETCH_HARDENING.md` | CLOSED |
| Task 50 — ZX Spectrum Adapter | `archive/tasks/TASK_50_ZX_SPECTRUM_ADAPTER.md` | CLOSED |
| Task 53 — Sprite Pattern Address Width Expansion | `archive/artifacts/TASK_53_SPRITE_PATTERN_ADDRESS_WIDTH_EXPANSION.md` | CLOSED |

Apply this template starting with Task 19 immediately.

---

## Active Side Lanes

Side lanes are tracked here when they reach the implementation phase. Planning-only discussion stays in mail.

### HDMI Output Compatibility (Option A)

**Status:** CLOSED — seam proof converged at `f942c3a` / #8520
**PM authority:** BronzeGate #8521
**Audit owner:** CyanPeak

**Goal:** Improve HDMI observation-path robustness by migrating Tang Nano 20K output from VESA 640×480 to CEA-861 720p60, with a clean architectural seam between fixed transport and internal render geometry.

**Phased plan:** `PROJECT_PLAN/archive/artifacts/TASK_HDMI_OUTPUT_COMPATIBILITY_OPTION_A.md` (commit `d60b38b`)

**Outcome:** The HDMI compatibility seam-proof objective is **successfully demonstrated**. Native-rate (25.2 MHz) writer side can feed the proven 720p transport shell (74.25 MHz) via a 4-pixel-pack `StreamFifoCC` CDC seam, with zero VdpTop changes and zero timing violations.

**Completed slices:**

| Slice | Description | Commit | Audit | Evidence |
|---|---|---|---|---|
| A | HDMI clean-start mute on `pll.LOCK` rise | `7f00a37` | PASS #8481 | Sim 6/6; 3× reflash hardware lock/re-lock PASS |
| B | 720p output-shell synthetic-source proof | `f0b774b` | PASS #8485 | Sim 6/6; 3× reflash 720p SMPTE bars lock PASS |
| C | Output mapper / centered 640×480-in-1280×720 bridge | `9b3fd85` + `70dd6ca` | PASS #8490 | Sim 6/6 + 8 boundary checks; 3× reflash 720p bridge lock PASS |
| D-B1-L | Dual-clock CDC seam: native-rate 4-pixel-pack writer → StreamFifoCC → 720p reader + centered bridge | `f942c3a` | PASS #8520 | Build 0 violations; 3× reflash 8-bar SMPTE lock PASS; 4-pixel-pack rate-matches 25.2→74.25 MHz |

**Blocked / informative slices:**

| Slice | Description | Commit | Blocker | Outcome |
|---|---|---|---|---|
| D-A | VdpTop test-pattern under 720p shell (clock-enable @ 74.25 MHz) | `7f8e46d` | Timing: 8,873 setup violations, TNS −27.5 µs, worst slack −20.7 ns on `vCounter → lineBuf/DI` | Closed as BLOCKED. Proves VdpTop cannot run at 74.25 MHz without substrate pipelining. |
| D-B1-A | Synthetic SDRAM frame-buffer proof | — | SDRAM controller sustained write bandwidth ~13 MB/s; full-frame write exceeds budget by ~3× | Closed as BLOCKED before implementation. BrightForge #8504. BronzeGate #8505. |

### Host-Init Sidecar Phase 1 + Phase 2 + Phase 3

**Status:** DONE — Phase 1 causality PROVEN (#9001); Phase 2 SDRAM upload PROVEN (#9010); Phase 3 palette upload PROVEN (#9022)
**PM authority:** BronzeGate #8979 / #8984 / #8994 / #8999 / #9008 / #9019 / #9021
**Audit owner:** CyanPeak #9001 / #9010 / #9022 / #9023 (all PASS — lane officially closed)

**Goal:** Move bootstrap register/copper initialization (Phase 1) and SDRAM data initialization (Phase 2) from FPGA internal FSM to host control (ESP8266 NodeMCU), proving the FPGA can be fully initialized by an external host via QSPI.

**Scope boundary:** Phase 1 = register/copper init. Phase 2 = SDRAM bitmap+attr upload. No ROM elimination. Other scenarios remain on internal bootstrap for now.

**Completed sub-slices:**

| Sub-slice | Description | Status | Evidence |
|---|---|---|---|
| FPGA RTL Phase 1 | `useHostInit` flag + bootstrap bypass in `TopTang20kHdmi.scala` | **DONE** | Gen-verified; bitstream flashed; fallback render correct |
| FPGA RTL Phase 2 | `skipSdramInit` param in `BitmapRowFetch.scala` | **DONE** | FSM bypasses init states cleanly; no fetch logic regression |
| Host sketch Phase 1 | `sc45_host_init()` sequence (220 copper words + 9 registers) | **DONE** | Compiles; runs end-to-end on ESP8266 |
| Host sketch Phase 2 | `vdp_sdram_write()` + `sc45_host_signature_upload()` (8 rows bitmap+attr) | **DONE** | Signature visible at HDMI lines 40–55 |
| Host sketch Phase 3 | `vdp_palette_write_entry()` + `sc45_host_palette_upload()` (128 entries via `0x0600`/`0x0601`) | **DONE** | Red-dominant bitmap + grayscale ramp visually unmistakable from default Spectrum |
| Bench bring-up | ESP32-C3 bad silicon → classic ESP32 wiring → ESP8266 alive | **DONE** | #8985 (bad silicon), #8987–8993 (alternate host alive) |
| Live toggle proof | `loop()` alternates `LAYER_ENABLE` 0x0001↔0x0000 every 2s | **DONE** | #9000: 7 edges / 26 frames, 2.000s square wave, mean 110↔5, dark 6%↔96% |
| Signature proof | Host-uploaded `0xAA`/`0x55` stripes at rows 20–27 | **DONE** | #9009: std 42.5 (signature) vs 79.2 (uninit), dramatic visual contrast |

**Proof gap:** CLOSED. Host causality, SDRAM data ownership, and palette ownership all proven.

**Blocked / deferred:**
- Tile/sprite ROM elimination — deferred to future "full zero-footprint" lane per #9019
- `skipPaletteInit` RTL param — deferred per #9019 (existing ~5 µs init walk not on critical path)
- E3.* probe cleanup — deferred per #9019

---

**Active slice:**
- **None** — Host-Init Phases 1–3 closed. Next lane awaiting PM activation.

**Planning artifacts:**
- CoralReef #8500: D-B planning packet (options D-B1 SDRAM frame buffer, D-B2 pipelining, D-B3 480p fallback)
- CyanPeak #8501: D-B planning audit PASS; D-B1 strategy approved, D-B2 rejected, D-B1-A implementation authorized
- CoralReef #8502: SDRAM arbiter / CDC topology recon
- CoralReef #8507: CDC/line-buffer research for D-B1-L implementation

**Paused dependencies:**
- Fun-demo F2 QSPI-burst investigation paused at `e0f8078`
- Fun-demo preload animation research parked as research-only per BronzeGate #8514. CoralReef #8517 delivered.

**Key research:**
- CoralReef #8475: PLL path, serializer headroom, bridge mode, proof scenarios
- CoralReef #8502: SDRAM arbiter interface recon, CDC topology analysis
- CoralReef #8510: Host bus feasibility, shapes, Pico abstraction, risks
- CoralReef #8517: Preload animation storage math, playback architecture, risks

---

### Mode2optimized Compile-Time Feature Strip

**Status:** DONE — bitstream produced `22afb90` / BrightForge #10142 / CoralReef audit closeout
**PM authority:** BronzeGate #10071 / #10075 / #10082 / #10126 / #10135 / #10138 / #10140 / #10141
**Audit owner:** CoralReef

**Goal:** Recover the `mode2optimized` rich-top default build fit on GW2AR-LV18 by adding compile-time feature gates and Mem-inference hardening.

**Scope boundary:** Compile-time gates for L2/L3, extra raster triggers, second window, affine, and parameterized `planeCount`. Plus Mem-inference hardening as needed. No runtime register-map expansion. No adapter rewrites. No hardware proof in this lane.

**Completed slices:**

| Slice | Description | Commit | Result |
|---|---|---|---|
| Gate #1 | `withExtraRasterTriggers` compile-time gate | `5020344` | Spinal clean; DFF blocker exposed (+5485) |
| Diagnosis | Root-cause: `activeListMem` 9× readAsync ports | `10125` | Identified cascading Mem→FF promotion |
| Fix #1 | `activeListMem` readport-trim to 1 port | `40c0384` | DFF blocker resolved; synth advances to logic check |
| PlaneRows trim | `BitplaneRowFetch.planeRows` legacy removal | `bc0e493` | Preventive; zero immediate resource impact |
| Gate #2 | `enableL2L3` compile-time gate | `f0a09e2` | Logic savings confirmed (-514 LUTs); DFF re-triggered |
| LinestateStore BSRAM | `prepare` Mem readAsync→readSync+BSRAM | `49c3a5f` / `2f7c92d` | +5353 DFFs reclaimed; +128 remain |
| slbA/slbB BSRAM | `SpriteRasterizer` lookahead readSync pattern per qa.md A-001 | `22afb90` | **Bitstream produced**; -11518 DFFs net via reverse cascade |

**Final Tang Nano result (`22afb90`):**

| Metric | Value | Limit | Headroom |
|---|---|---|---|
| Logic | 5874 | 20736 | 72% |
| LUT | 5874 | — | — |
| Register | 3791 | 15915 | 76% |
| Logic Reg as FF | 3762 | 15552 | 76% |
| CLS | 6888 | 10368 | 33% |
| BSRAM | 25 | 46 | 46% |
| DSP | 2 | 12 | 83% |

**Key findings:**
- GT-023: GW2AR-18 hardware FF/LUT ratio cap = 0.75 (UG288 §2.1.1). CLS3 REGs unsupported on this device.
- GT-026 cascade fragility: Mem→FF promotion is global; fixing one large Mem can trigger reverse cascade saving thousands of DFFs.
- MemReport tool (`47f0a87`, `d32f446`) provides elaboration-time inventory + GT-023 ratio analysis.

**Blocked / deferred:**
- Gate #3 (`enableAffine`) and Gate #4 (`planeCount=5`) re-enable per-scenario — deferred to future PM authorization
- Hardware flash + visual proof — deferred to TopazCliff authorization

**Sources:**
- CoralReef #10070: preflight recommendation
- BrightForge #10076, #10125, #10127, #10128, #10130, #10134, #10137, #10139, #10142
- BronzeGate #10126, #10135, #10138, #10140, #10141
- CyanPeak #10121 (advisory PASS on Gate #1 implementation)

---

### Task 10026 — Barebones Simple Sprite over Background

**Status:** DONE — audit PASS #10117 (CyanPeak via HumanOverseer)
**PM authority:** BronzeGate #10077 / #10080 / #10082
**Audit owner:** CyanPeak
**Implementation owner:** BrightForge
**Firmware owner:** TopazCliff (landing); FoggyWolf (original sketch)

**Goal:** Add the smallest proof-sized sprite primitive to the proven barebones substrate (working L0/L1 scroll path).

**Scope boundary:** One procedural 16×16 white sprite only. No sprite engine expansion, no SDRAM sprite path, no rich-top recovery work, no multi-sprite batching.

**Completed checkpoints:**

| Checkpoint | Description | Evidence |
|---|---|---|
| A | Implementation plan / sprite contract / proof shape | BrightForge #10078 |
| B | Implementation + sim proof | `TopTang20kBarebonesSim` PASS (6/6 cases) #10081 |
| C | Hardware proof | ESP8266 + ESP32 sketches flashed; TopazCliff #10116 confirms motion/visibility |
| D | Audit + ledger sync | CyanPeak #10117 PASS; CoralReef ledger sync `4ff4502` |

**Exact files changed:**
- `hw/spinal/spinalhdlvdp/TopTang20kBarebones.scala` — sprite regs 0x0004/0x0005 + procedural hit + compositor priority
- `hw/spinal/spinalhdlvdp/TopTang20kBarebonesSim.scala` — sprite tests
- `firmware/esp8266_barebones_sprite/esp8266_barebones_sprite.ino` — proof sketch
- `firmware/esp32_barebones_sprite/esp32_barebones_sprite.ino` — parity sketch

**Commits:** `eda89d7` (RTL), `6119360` (ESP32), `40f1424` (ESP8266)

**Key design decisions:**
- Procedural shape (no Mem) to sidestep `project_tang20k_mem_fragility`
- Hardcoded color `0xFFFFFF` for unambiguous OpenCV detection
- Priority: `sprite > L1 > L0`
- No enable bit; host parks sprite off-screen to hide

---
