psymon101/spinalhdlVDP/PROJECT_PLAN/proof_packets/qspi-upload-si-hardening/manifest.yaml

lane: qspi-upload-si-hardening
owners: [BrightForge, BronzeGate]
pm: TopazCliff
status: REVIEW_READ_DONE_HARDWARE_PASS
date: 2026-08-01
source_commit: 158b9d7c
firmware_proof_commits: [619f76b8, 3b246fc7, 2d066b5e]
memcpy_overlap_fix_commit: 619f76b8
firmware_path: firmware/libvdp/vdp_host_p4.c
firmware_contract: QSPI-CRC8-185
bitstream: fpga/tang20k/impl/pnr/project_38002d5c_scaler_hwproof.fs
bitstream_sha256: 38002d5c2bd1ca00c9460fc0349874a5e0f65afad120ab19c26b2144d41b9c09
firmware_build:
  project: firmware/esp32p4_scaler_proof
  tool: ESP-IDF v6.0.2
  target: ESP32-P4 v1.3
  build_commit: 70c43d7a
  elf_sha256: fd592e3562e8a278b200b0c95f5a0f8ec2d2709c15ed54a441b572e48018907a
  bin_sha256: cb977e17bedcfe639382c6d2f16fcd79649e1aca5f66dc252b09521e0249ca8c
  partition_sha256: fd8026bff850ca0dee41c41305160317fffe604dda30a9bd5a701ac82d96fa17
double_read_proof:
  firmware_mode: 6
  elf_sha256: 43e02289df7218f86ac236959d3202117a8e4ec710b971b367aa19290634a35c
  bin_sha256: dbd26957392fef6cb04668f02e776f17eaecb5928d5995046de204c69d1050d5
  partition_sha256: fd8026bff850ca0dee41c41305160317fffe604dda30a9bd5a701ac82d96fa17
  repeats: 8
  addresses: [0x100004, 0x100008, 0x10000C, 0x100FFC, 0x101000, 0x101004]
  expected_nonzero_addresses: [0x100008, 0x10000C, 0x101000, 0x101004]
  first_and_second_nonzero_matches: 0
  read_errors: 0
  health: raw=0x00000000,overflow=0,malformed=0
  initial_attempt_upload_error: VDP_HOST_ERR_TX_at_offset_1518
  rerun_clean_upload: true
  rerun_elf_sha256: b66b1747c3f0aa19ea318b59faeca251636a4246a85c0499688e13c7e7b709de
  rerun_bin_sha256: ed4fb5d01dc2b339069f7ebad076771a7cd9bba6af019bb7d144e6ff79633944
  rerun_serial_log_sha256: 0fa2965cbc2a220293ba2e63ae31bbc1d1472d9eee1a1b70d7532b9a57e35954
  first_and_second_nonzero_matches_valid_run: 0
  read_errors_valid_run: 0
  health_valid_run: raw=0x00000000,overflow=0,malformed=0
  dummy_neighbor_lag_matches: 16
  dummy_neighbor_samples: 16
  target_matches: 0
  result: clean_rerun_second_call_zero_fork_unresolved
  artifacts:
    - firmware/DOUBLE_READ_BUILD.md
    - hardware/DOUBLE_READ_PROCEDURE.md
    - hardware/DOUBLE_READ_RESULTS.md
display_indirect_proof:
  firmware_mode: 7
  elf_sha256: dd169667e4b50bfbbbb455db837b1973179bc0c2d57cc36d3197c10e040a4565
  bin_sha256: ad5331cfb8cd7b3a9914f8cf8ddf8d5b9ca7c05a4aa486e5dd818660c8e9e269
  partition_sha256: fd8026bff850ca0dee41c41305160317fffe604dda30a9bd5a701ac82d96fa17
  targets: [0x100008, 0x101000]
  byte_pattern: 0xAA
  health: raw=0x00000000,overflow=0,malformed=0
  serial_ready: true
  capture_frames: 3
  capture_sha256: a2a67849bdeb2f6ef4bbaba841797948181d22dd19b41f5d7443f73eb0a3e49b
  result: no_clean_palette2_confirmation
  artifacts:
    - firmware/DOUBLE_READ_BUILD.md
    - hardware/INDIRECT_DISPLAY_PROCEDURE.md
    - hardware/INDIRECT_DISPLAY_RESULTS.md
    - captures/indirect_display_frame_01.png
read_done_proof:
  firmware_mode: 8
  source_commit: 158b9d7c
  interface_spec:
    selector: 0x0C
    bit: 0
    polarity: high_true
    clear_on: 0x0327_arm_write
    set_on: settled_pixel_domain_result_latch
    data_selector: 0x08
  elf_sha256: fd592e3562e8a278b200b0c95f5a0f8ec2d2709c15ed54a441b572e48018907a
  bin_sha256: cb977e17bedcfe639382c6d2f16fcd79649e1aca5f66dc252b09521e0249ca8c
  partition_sha256: fd8026bff850ca0dee41c41305160317fffe604dda30a9bd5a701ac82d96fa17
  target_addresses: [0x100008, 0x101000]
  repeats: 8
  upload_clock_hz: 4000000
  read_clock_hz: 2000000
  hardware_status: pass_after_ftdi_driver_recovery
  sram_load_sha256: 0c218b9a1f6d68fa53ea26dc4e9176fd1d52751cc82ca335a3eb95f0478b31e2
  serial_log_sha256: b86647404db6b89d04c563879e044a22596bff147f68600d00336ad416ef3ed8
  curated_serial_sha256: d3718b84bcd8060498fe672a45e87515b591ddc46ad3df97b3c007e000c76e2d
  upload_status: PASS
  health_after_read: raw=0x00000000,overflow=0,malformed=0
  target_results:
    0x100008: {expected: 0x55555555, returned: 0x55555555, repeats: 8, polls_total: 8, max_polls: 1}
    0x101000: {expected: 0x55555555, returned: 0x55555555, repeats: 8, polls_total: 8, max_polls: 1}
  result: pass_sdram_clean_readback_cdc_fork
  brightforge_rtl:
    rtl_source_commit: 5ef5db2a
    rtl_branch: brightforge/read-done-diag
    generated_rtl: hw/gen/top_tang20k.v
    generated_rtl_sha256: ff01ab712a1758b1844a60459cbfaf2f2e628bf20ed45bcb2ae77e13ede5bccb
    sbt_compile: PASS
    cdc_cosim: ReadDoneCdcSim
    cdc_cosim_result: ALL_PASS
    cdc_cosim_caveat: Verilator models BufferCC as ideal 2-FF (no metastability); proves handshake logic, not real-timing margin. HW is the arbiter.
    sta_3build:
      task: bj9ocj9x9
      builds: 3
      tns_all_clocks: 0
      bsram: 40/46
      no_new_bsram: true
      no_regression: true
      build_shas:
        - 05bc5ede09b2cbba21139dd8cae75ec2ad34f40c0fc765fcddc774f2bfcbdaeb
        - 6fd0a81f17db852381096d0d3e491c74ae789064530dcabf016418629ebe1353
        - 0c218b9a1f6d68fa53ea26dc4e9176fd1d52751cc82ca335a3eb95f0478b31e2
    authoritative_bitstream: fpga/tang20k/impl/pnr/project_0c218b9a_readdone.fs
    authoritative_bitstream_sha256: 0c218b9a1f6d68fa53ea26dc4e9176fd1d52751cc82ca335a3eb95f0478b31e2
    fmax_tightest: clk_pixel 29.101MHz @ 25.200MHz (+15.5%)
    tool: Gowin V1.9.12.01
    device: GW2AR-LV18QN88C8/I7
  artifacts:
    - firmware/READ_DONE_BUILD.md
    - hardware/READ_DONE_RESULTS.md
    - hardware/READ_DONE_SERIAL.md
    - simulation/READ_DONE_CDC_COSIM.md
    - simulation/read_done_cdc_cosim.log
    - synthesis/STA_3BUILD_SUMMARY.md
transport:
  bulk_clock_hz: 4000000
  control_clock_hz: 2000000
  crc_status_selector: 11
  retry_attempts: 2
stress:
  cycles: 30
  pass: 15
  fail: 15
  residual_mismatches_per_failed_cycle: 2
  health: raw=0x00000000,overflow=0,malformed=0
diagnostic:
  mode: 4
  sample_repeats: 8
  sample_addresses: 13
  sample_reads: 104
  sample_clock_hz: 2000000
  upload_frame_words: 253
  upload_frame_bytes: 506
  bitmap_frames: 61
  attr_frames: 61
  stable_zero: true
  crc_counter_delta_frames: 6
refresh_pressure_cross_check:
  date: 2026-07-31
  approved_bitstream_sha256: 38002d5c2bd1ca00c9460fc0349874a5e0f65afad120ab19c26b2144d41b9c09
  target_addresses: [0x100008, 0x101000]
  expected_value: 0x55555555
  upload_clock_hz: 4000000
  read_clock_hz: 2000000
  mode4_layer_disabled:
    n: 30
    pass: 0
    fail: 30
    target_mismatches: 60
    health: raw=0x00000000,overflow=0,malformed=0
    elf_sha256: 32e643a31e070dfc1d3d03c17acbc04ac760c70c12f84c13984032cce93c5830
    bin_sha256: abadf79b5f23a167e9597a99ebece2ee62462a81978e304420fb42075364cd6a
  mode0_layer_enabled:
    n: 30
    pass: 0
    fail: 30
    target_mismatches: 60
    health: raw=0x00000000,overflow=0,malformed=0
    elf_sha256: 6dce108ff57c3340f4c8985ead2b16ccade9092873643e5511506efb73056649
    bin_sha256: 29c0cb7a75d770e968d39b31121db5aad9e1940f643beebfe7667769c2668a58
  correlation: no workload scaling observed; both conditions were deterministic 30/30 failures
  artifacts:
    - hardware/REFRESH_PRESSURE_PROCEDURE.md
    - hardware/REFRESH_PRESSURE_RESULTS.md
    - firmware/REFRESH_PRESSURE_BUILD.md
firmware_framing_readback_audit:
  artifact: firmware/FRAMING_READBACK_AUDIT.md
  assignment_mail: 14539
  findings_mail: 14540
  source_files:
    - firmware/libvdp/vdp_host_p4.c
    - firmware/esp32p4_scaler_proof/main/main.c
  frame_words: 253
  frame_bytes: 506
  target_0x100008:
    frame: 0
    frame_address: 0x100000
    frame_byte_offset: 8
    payload_byte_offset: 10
    expected_bytes: 55555555
    wire_address: 0x100000
    crc8: DF
  target_0x101000:
    frame: 8
    frame_address: 0x100FD0
    frame_byte_offset: 48
    payload_byte_offset: 50
    expected_bytes: 55555555
    wire_address: 0x900FD0
    crc8: 67
  alternate_p4_sdram_readback: unavailable_without_rule19_interface_change
  production_edit: none
  rule10_search: complete
mail: [14506, 14507, 14508, 14509, 14510, 14511, 14512, 14531, 14532, 14533, 14534, 14537, 14538, 14539, 14540, 14542, 14543]
decision: Host framing/address/CRC audit is clean; faithful transport/bridge proof is clean; no production fix is authorized until an approved alternate readback or physical-layer test isolates the residual and BrightForge/TopazCliff complete the Rule 19 checkpoint.
sclk_sweep:
  assignment_mail: 14547
  acknowledgement_mail: 14549
  firmware_mode: 5
  requested_rates_hz: [2000000, 1000000, 500000, 250000]
  cycles_per_rate: 30
  addresses: [0x100004, 0x100008, 0x10000C, 0x100FFC, 0x101000, 0x101004]
  cs_posttrans: 8
  upload_clock_hz: 4000000
  per_rate_reads: 180
  per_rate_expected_zero_matches: 60
  per_rate_expected_nonzero_mismatches: 120
  per_rate_read_errors: 0
  health_each_rate: raw=0x00000000,overflow=0,malformed=0,errors=0
  result: stable_zero_at_all_rates
  next_decision: display_indirect_readback_or_physical_bus_capture
