psymon101/spinalhdlVDP/PROJECT_PLAN/proof_packets/external-review-scaler-rewrite-p3b/source/vdptop_diff_stat.txt

 hw/spinal/spinalhdlvdp/VdpTop.scala | 50 ++++++++++++++++++++++++-------------
 1 file changed, 32 insertions(+), 18 deletions(-)
