psymon101/spinalhdlVDP/firmware/esp32s3_sdram_probe/esp32s3_sdram_probe.ino

/**
 * BronzeGate Hardware Probe (esp32s3_sdram_probe)
 * 
 * Target: ESP32-S3 (NodeMCU-like dev board)
 * Purpose: Interactive UART probe to execute the hardware verification matrix
 *          against the Tang Nano 20K VDP.
 */

#include "vdp_platform.h"
#include <vdp_host.h>
#include "vdp_mode0.h"
#include "vdp_upload.h"
#include "vdp_status.h"

uint32_t current_host_speed = VDP_QSPI_SCK_HZ;

struct UploadAcceptResult {
    uint32_t status;
    uint32_t last_err;
    uint8_t observed_counter;
    bool timeout;
};

void select_read_speed() {
    // Fixed-rate diagnostic: never tear down/re-add SPI2 after initialization.
}

void apply_host_speed() {
    vdp_host_set_speed_hz(current_host_speed);
}

void do_status() {
    select_read_speed();
    uint32_t magic = vdp_read_status(0);
    uint32_t err = vdp_read_status(4);
    uint32_t sticky = vdp_read_status(5);
    Serial.printf("STATUS: magic=%08X last_err=%02X sticky=%08X\n", magic, err, sticky);
}

void setup() {
    Serial.begin(115200);
    delay(2000); // Wait for terminal
    
    Serial.println("\n\n=== BronzeGate HW Probe ===");
    Serial.println("Commands:");
    Serial.println("  w <addr> <data> : Write DWORD to SDRAM (hex)");
    Serial.println("  r <addr>        : Read DWORD from SDRAM (hex)");
    Serial.println("  s <hz>          : Set diagnostic rate (1000000 or 3000000)");
    Serial.println("  u               : Raw upload status (READ_STATUS sel=6)");
    Serial.println("  b <addr> <count> <data> : No-poll DWORD burst to SDRAM");
    Serial.println("  f               : Flush SDRAM FIFOs");
    Serial.println("  t               : Run HW data-path matrix; may set sticky uploadError");
    Serial.println("                    in tight-poll mode. Use w+u pacing for status-clean checks.");
    
    // Initialize libvdp
    vdp_host_init();
    apply_host_speed();
    Serial.printf("host read-safe=%u Hz write-selected=%u Hz cap=%u Hz\n",
                  VDP_QSPI_SCK_HZ, current_host_speed, VDP_QSPI_SCK_WRITE_HZ);
}

void do_read(uint32_t addr) {
    uint16_t addr_lo = addr & 0xFFFF;
    uint16_t addr_hi = (addr >> 16) & 0x007F;
    select_read_speed();
    vdp_reg_write(0x0326, addr_lo);
    vdp_reg_write(0x0327, addr_hi | 0x8000); // Arm
    delay(1);
    uint32_t val = vdp_read_status(8);
    Serial.printf("READ  [%06X] = %08X @ %u Hz\n", addr, val, current_host_speed);
}

bool do_write(uint32_t addr, uint32_t data) {
    uint16_t buffer[2] = { (uint16_t)(data & 0xFFFF), (uint16_t)(data >> 16) };
    if (vdp_upload_asset(addr, buffer, 2, NULL)) {
        Serial.printf("WRITE [%06X] = %08X @ %u Hz\n", addr, data, current_host_speed);
    } else {
        Serial.println("WRITE FAILED (Timeout/Busy)");
        select_read_speed();
        return false;
    }
    select_read_speed();
    return true;
}

void do_upload_status() {
    uint32_t upload = vdp_read_status(6);
    uint32_t err = vdp_read_status(4);
    uint32_t sticky = vdp_read_status(5);
    Serial.printf("UPLOAD_STATUS: upload=%08X last_err=%08X sticky=%08X @ %u Hz\n",
                  upload, err, sticky, current_host_speed);
}

bool poll_upload_clear(const char *label) {
    const uint32_t timeout_ms = 100;
    const uint32_t start = millis();
    uint32_t upload = 0;
    do {
        upload = vdp_read_status(6);
        if ((upload & 0x1u) == 0) {
            Serial.printf("POLL  %-8s upload=%08X last_err=%08X CLEAR\n",
                          label, upload, vdp_read_status(4));
            return true;
        }
    } while ((millis() - start) < timeout_ms);
    Serial.printf("POLL  %-8s upload=%08X last_err=%08X TIMEOUT\n",
                  label, upload, vdp_read_status(4));
    return false;
}

bool poll_upload_accept(const char *label, uint8_t expected_counter, UploadAcceptResult *result) {
    const uint32_t timeout_ms = 100;
    const uint32_t start = millis();
    uint32_t upload = 0;
    uint32_t err = 0;
    if (result) {
        result->status = 0;
        result->last_err = 0;
        result->observed_counter = 0;
        result->timeout = false;
    }
    do {
        upload = vdp_read_status(6);
        err = vdp_read_status(4);
        uint8_t observed = (uint8_t)((upload >> 8) & 0xFFu);
        bool busy = (upload & VDP_UPLOAD_STATUS_BUSY) != 0;
        bool error = (upload & VDP_UPLOAD_STATUS_CLEAR_MASK) != 0;
        if (result) {
            result->status = upload;
            result->last_err = err;
            result->observed_counter = observed;
        }
        if (!busy) {
            bool accepted = !error && observed == expected_counter;
            Serial.printf("ACK   %-8s upload=%08X exp=%02X got=%02X last_err=%08X %s\n",
                          label, upload, expected_counter, observed, err,
                          accepted ? "ACCEPT" : "NAK");
            return accepted;
        }
    } while ((millis() - start) < timeout_ms);
    if (result) {
        result->status = upload;
        result->last_err = err;
        result->observed_counter = (uint8_t)((upload >> 8) & 0xFFu);
        result->timeout = true;
    }
    Serial.printf("ACK   %-8s upload=%08X exp=%02X got=%02X last_err=%08X TIMEOUT\n",
                  label, upload, expected_counter, (uint8_t)((upload >> 8) & 0xFFu), err);
    return false;
}

void do_flush() {
    Serial.println("Flushing SDRAM FIFOs (256 zeros)...");
    uint16_t zeros[128] = {0};
    vdp_upload_asset(0, zeros, 128, NULL);
    vdp_upload_asset(0, zeros, 128, NULL);
    Serial.println("Flush complete.");
}

void do_burst(uint32_t addr, uint16_t count, uint32_t data) {
    uint16_t buffer[2] = { (uint16_t)(data & 0xFFFF), (uint16_t)(data >> 16) };
    Serial.printf("BURST start=%06X count=%u data=%08X @ %u Hz (NO per-tile poll)\n",
                  addr, count, data, current_host_speed);
    for (uint16_t i = 0; i < count; i++) {
        uint32_t tile_addr = addr + (uint32_t)i * 4u;
        vdp_sdram_write(tile_addr, buffer, 2);
        Serial.printf("BURST_WRITE [%02u] [%06X] = %08X\n", i, tile_addr, data);
    }
    poll_upload_clear("burst");
    do_upload_status();
}

void do_matrix() {
    Serial.println("\n--- RUNNING HW MATRIX ---");
    Serial.println("NOTE: t uses ACK/NAK counter polling and aborts on first failed frame.");
    uint32_t baseline = vdp_read_status(6);
    uint8_t expected_counter = (uint8_t)(((baseline >> 8) + 1u) & 0xFFu);
    Serial.printf("ACK baseline upload=%08X next=%02X\n", baseline, expected_counter);
    uint32_t sent_addr = 0x00B000;
    uint32_t sent_data = 0x22221111;
    UploadAcceptResult fail = {0, 0, 0, false};

    bool matrix_ok = true;
    bool sentinel_ok = false;
    for (int attempt = 1; attempt <= 3; attempt++) {
        do_write(sent_addr, sent_data);
        if (poll_upload_accept("sentinel", expected_counter, &fail)) {
            expected_counter = (uint8_t)((expected_counter + 1u) & 0xFFu);
            sentinel_ok = true;
            break;
        }
        Serial.printf("RETRY sentinel attempt=%d status=%08X exp=%02X got=%02X last_err=%08X\n",
                      attempt, fail.status, expected_counter, fail.observed_counter, fail.last_err);
        if (attempt < 3 && (fail.status & VDP_UPLOAD_STATUS_CLEAR_MASK) != 0) {
            vdp_clear_upload_status((uint16_t)(fail.status & VDP_UPLOAD_STATUS_CLEAR_MASK));
        }
    }
    if (!sentinel_ok) {
        Serial.printf("MATRIX FAIL sentinel status=%08X exp=%02X got=%02X last_err=%08X timeout=%u\n",
                      fail.status, expected_counter, fail.observed_counter, fail.last_err,
                      fail.timeout ? 1u : 0u);
        matrix_ok = false;
    }
    
    uint32_t tile_addr = 0x00A000;
    uint32_t tile_data = 0x0000FFFF;
    int tiles_attempted = 0;
    if (matrix_ok) {
        Serial.printf("Writing 32x %08X to %06X...\n", tile_data, tile_addr);
        for (int i=0; i<32; i++) {
            char label[9];
            snprintf(label, sizeof(label), "tile[%02d]", i);
            bool accepted = false;
            for (int attempt = 1; attempt <= 3; attempt++) {
                do_write(tile_addr + (i*4), tile_data);
                if (poll_upload_accept(label, expected_counter, &fail)) {
                    expected_counter = (uint8_t)((expected_counter + 1u) & 0xFFu);
                    accepted = true;
                    tiles_attempted = i + 1;
                    break;
                }
                Serial.printf("RETRY %-8s attempt=%d status=%08X exp=%02X got=%02X last_err=%08X\n",
                              label, attempt, fail.status, expected_counter, fail.observed_counter, fail.last_err);
                if (attempt < 3 && (fail.status & VDP_UPLOAD_STATUS_CLEAR_MASK) != 0) {
                    vdp_clear_upload_status((uint16_t)(fail.status & VDP_UPLOAD_STATUS_CLEAR_MASK));
                }
            }
            if (!accepted) {
                Serial.printf("MATRIX FAIL tile[%02d] addr=%06X status=%08X exp=%02X got=%02X last_err=%08X timeout=%u\n",
                              i, tile_addr + (i*4), fail.status, expected_counter,
                              fail.observed_counter, fail.last_err, fail.timeout ? 1u : 0u);
                matrix_ok = false;
                break;
            }
        }
    }
    
    Serial.println("\nVerifying...");
    do_read(sent_addr);
    for (int i=0; i<tiles_attempted; i++) {
        do_read(tile_addr + (i*4));
    }
    do_read(sent_addr);
    Serial.printf("MATRIX SUMMARY: %s tiles_attempted=%d next_counter=%02X\n",
                  matrix_ok ? "PASS" : "FAIL", tiles_attempted, expected_counter);
    Serial.println("--- MATRIX COMPLETE ---\n");
}

void loop() {
    if (Serial.available()) {
        String cmd = Serial.readStringUntil('\n');
        cmd.trim();
        if (cmd.length() == 0) return;
        char op = cmd.charAt(0);
        if (op == 's') {
            if (cmd.length() == 1) {
                do_status();
                return;
            }
            uint32_t hz = cmd.substring(2).toInt();
            if (hz != 1000000u && hz != VDP_QSPI_SCK_HZ) {
                Serial.println("Diagnostic rate: use 1000000 or 3000000.");
                return;
            }
            current_host_speed = hz;
            apply_host_speed();
            Serial.printf("Write speed selected: %u Hz\n", current_host_speed);
        }
        else if (op == 'u') {
            do_upload_status();
        }
        else if (op == 'f') {
            do_flush();
        }
        else if (op == 'r') {
            uint32_t addr = strtoul(cmd.substring(2).c_str(), NULL, 16);
            do_read(addr);
        }
        else if (op == 'w') {
            int space = cmd.indexOf(' ', 2);
            if (space > 0) {
                uint32_t addr = strtoul(cmd.substring(2, space).c_str(), NULL, 16);
                uint32_t data = strtoul(cmd.substring(space + 1).c_str(), NULL, 16);
                do_write(addr, data);
            }
        }
        else if (op == 'b') {
            int space1 = cmd.indexOf(' ', 2);
            int space2 = (space1 > 0) ? cmd.indexOf(' ', space1 + 1) : -1;
            if (space1 > 0 && space2 > 0) {
                uint32_t addr = strtoul(cmd.substring(2, space1).c_str(), NULL, 16);
                uint16_t count = (uint16_t)strtoul(cmd.substring(space1 + 1, space2).c_str(), NULL, 0);
                uint32_t data = strtoul(cmd.substring(space2 + 1).c_str(), NULL, 16);
                do_burst(addr, count, data);
            }
        }
        else if (op == 't') {
            do_matrix();
        }
        else {
            Serial.println("Unknown command.");
        }
    }
}
