psymon101/spinalhdlVDP/firmware/esp32_sc62_sprite_flip/esp32_sc62_sprite_flip.ino

/**
 * esp32_sc62_sprite_flip.ino — Task 52 sprite-flip HW proof host sketch.
 *
 * Sc62: upload one asymmetric 16×16 4bpp sprite pattern into pattern slot 0.
 * The sc62 case in TopTang20kHdmi.scala (scenarioId=62) handles all
 * sprite-descriptor configuration via its copper program.
 *
 * Expected on-screen result:
 *   x= 80 : reference L
 *   x=200 : flipH only
 *   x=320 : flipV only
 *   x=440 : flipH+flipV
 *
 * This version reuses libvdp for transport.
 *
 * Board:  ESP32 dev1
 * FQBN:   esp32:esp32:esp32
 */

#include <Arduino.h>
#include <vdp_qspi.h>
#include <vdp_mode0.h>

// Asymmetric L-shape: col 0 OR row 15 → palette index 1, elsewhere → 0.
static inline uint8_t pattern_pixel(uint8_t row, uint8_t col)
{
    return (col == 0 || row == 15) ? 0x1 : 0x0;
}

static void sc62_upload_pattern(void)
{
    Serial.println("sc62: uploading 16x16 4bpp asymmetric-L pattern to slot 0...");

    uint16_t pixels[256];
    for (uint8_t row = 0; row < 16; ++row) {
        for (uint8_t col = 0; col < 16; ++col) {
            pixels[row * 16 + col] = (uint16_t)pattern_pixel(row, col);
        }
    }

    vdp_sprite_upload(/*slot=*/0, pixels, /*pattern_start=*/0, /*pattern_pixels=*/256,
                      /*palette=*/NULL, /*palette_start=*/0, /*palette_count=*/0,
                      /*cfg=*/NULL);

    Serial.println("sc62: pattern uploaded; sprite descriptors are configured by copper");
}

void setup(void)
{
    Serial.begin(115200);
    delay(50);
    Serial.println("ESP32 sc62 sprite-flip host (libvdp version) — booting");

    vdp_qspi_init();
    delay(200);
    sc62_upload_pattern();
    Serial.println("sc62 init done; idling (sprite descriptors driven by copper)");
}

void loop(void)
{
    delay(1000);
}
