psymon101/spinalhdlVDP/firmware/libvdp/vdp_copper.h

/**
 * vdp_copper.h — Minimal Copper program helpers for libvdp.
 *
 * Encodes Copper opcodes per Copper.scala BH-1 contract.
 * All opcodes are little-endian 16-bit words.
 */
#ifndef VDP_COPPER_H
#define VDP_COPPER_H

#include <stdint.h>
#include <stdbool.h>

#ifdef __cplusplus
extern "C" {
#endif

/**
 * Encode a legacy WAIT(Y) opcode (1 word).
 * Stalls copper until vCounter == Y AND hCounter == 0 (single-cycle match
 * window per frame, per Copper.scala sWaitStall). If the FSM misses the
 * match cycle, the WAIT waits a full frame.
 */
static inline uint16_t vdp_copper_wait(uint16_t y)
{
    return (uint16_t)(y & 0x3FFu);
}

/**
 * Encode a pixel-precise WAIT(X,Y) opcode header (2 words).
 * Returns the first word; caller must append Y as second word.
 */
static inline uint16_t vdp_copper_wait_xy(uint16_t x)
{
    return (uint16_t)(0x2000u | (x & 0x3FFu));
}

/**
 * Encode a WRITE_SEQ header word.
 * @param addr       11-bit register address
 * @param count_m1   N-1 where N = number of data words (0..7)
 * @return header word; caller must append data words after this.
 */
static inline uint16_t vdp_copper_write_seq_hdr(uint16_t addr, uint8_t count_m1)
{
    return (uint16_t)(0x8000u | (((uint16_t)(count_m1 & 0x7u)) << 11) | (addr & 0x7FFu));
}

/**
 * Encode a single WRITE opcode header (1 word).
 * The data word must follow immediately in the program stream.
 * addr is a 14-bit register-bus address (bits [13:0]).
 */
static inline uint16_t vdp_copper_write_op(uint16_t addr)
{
    return (uint16_t)(0x4000u | (addr & 0x3FFFu));
}

/**
 * Encode a JUMP opcode (1 word).
 */
static inline uint16_t vdp_copper_jump(uint16_t target_pc)
{
    return (uint16_t)(0xC000u | (target_pc & 0x1FFu));
}

/**
 * Encode a SKIP opcode (BH-2, 1 word).
 * @param cond   3-bit condition code
 * @param offset 5-bit skip offset in program words
 */
static inline uint16_t vdp_copper_skip_op(uint8_t cond, uint8_t offset)
{
    return (uint16_t)(0xE000u | (((uint16_t)(cond & 0x7u)) << 5) | (offset & 0x1Fu));
}

/**
 * Upload a copper program into FPGA copper RAM starting at 0x0400.
 * Uses vdp_reg_write_burst() for efficient contiguous writes.
 * @param prog     pointer to little-endian 16-bit opcode array
 * @param nwords   number of words (max 1024)
 */
void vdp_copper_upload(const uint16_t *prog, uint16_t nwords);

/**
 * Enable or disable the copper via VDP_CTRL @ 0x0310 bit[0].
 */
void vdp_copper_enable(bool en);

/**
 * Request an atomic bank swap on the next vSyncStart.
 * Copper must already be enabled. The swap promotes the inactive bank to
 * active and resets pc to 0. HW auto-clears the request bit after commit.
 * Writes 0x0003 to VDP_CTRL @ 0x0310 (keeps COPPER_ENABLE set).
 */
void vdp_copper_swap_request(void);

/**
 * Upload a copper program to the inactive bank and request an atomic swap.
 * Convenience wrapper that combines burst upload with swap request.
 * Precondition: copper must already be enabled so writes route to the
 * inactive bank. This helper closes the stale-bank hazard (CopperSim case 11)
 * by making the swap step unskippable.
 */
void vdp_copper_upload_and_swap(const uint16_t *prog, uint16_t nwords);

#ifdef __cplusplus
}
#endif

#endif /* VDP_COPPER_H */
